VladTeapa/Platforma-Autonoma-KL25Z/README.md

# Platforma-Autonoma-FRDM-KL25Z
Acest cod este realizat pentru o platforma autonoma realizata cu kitul de la NXP care urmareste o linie si ocoleste obstacolele.
Platforma folosita este FRDM-KL25Z.
Driver-ul de motoare este tot cel de la NXP rev. 0.
Senzorii de distanta sunt model HC-SR04+.
IDE-ul folosit este Keil.
