VladTeapa/Platforma-Autonoma-KL25Z/Hariga_George_C114C_Platforma_autonoma.docx

ROMÂNIA

MINISTERUL APĂRĂRII NAȚIONALE

ACADEMIA TEHNICĂ MILITARĂ ,,FERDINAND I”

FACULTATEA DE SISTEME INFORMATICE ȘI SECURITATE CIBERNETICĂ

Specializare: Calculatoare și Sisteme Informatice pentru Apărare și Securitate Națională

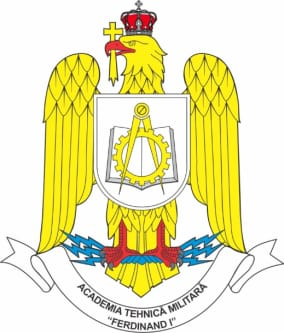
[picture p1: figure]

PLATFORMĂ AUTONOMĂ MOBILĂ CARE SE DEPLASEAZĂ URMÂND UN TRASEU MARCAT, IDENTIFICAT PRIN ANALIZĂ DE IMAGINE, CU OPTIMIZAREA TIMPULUI DE PARCURGERE A UNEI PORȚIUNI DELIMITATE DE TRASEU

CONDUCĂTOR ȘTIINȚIFIC:

Conf. univ. dr. ing Laurențiu MĂRGĂRIT

ABSOLVENT:

Student plt. maj. George-Codrin HARIGA

Conţine ___________ file

Inventariat sub nr. _____

Poziţia din indicator: ___

Termen de păstrare: ___

BUCUREȘTI

2021

# Abstract

This project aims to create an autonomous platform that travels on a delimited route with the possibility of avoiding obstacles that may arise along the way. The components used in the NXP Cup competition (formerly known as the Freescale Cup) are largely used.

The first chapter has an introductory role, where the project is described and its purpose, the choice of the project is described, a history of similar projects, which currently exists on the market and the working environment in which the source code for the project is made.

The second chapter has the role of presenting each component in general, their operating parameters, what role and what functionalities they have.

The third chapter presents the hardware configuration, how the development platform and auxiliary platform modules are physically linked. The amplifier platform and that of the distance sensors, their electrical diagrams and their functionality are also presented.

The fourth chapter has the role of presenting the software implementation. The implemented drivers and algorithms developed for line detection and avoiding obstacles are presented.

The fifth chapter presents the way in which the debugging was done, what tests were done to calibrate the system and to verify the functionalities. This chapter also contains UML diagrams to facilitate understanding of the algorithms and how to interact with the platform.

The sixth chapter presents the conclusions drawn and the problems encountered along with possible solutions.

# Rezumat

Acest proiect de licență își propune realizarea unei platforme autonome care să se deplaseze pe un traseu delimitat cu posibilitatea de a ocoli obstacolele care pot apărea pe parcurs. Se folosesc, în mare, componentele folosite la competiția NXP Cup (cunoscută in trecut ca și Freescale Cup).

Primul capitol are rol introductiv, unde, este descris proiectul și scopul acestuia, este descrisă alegerea proiectului, un istoric despre proiecte asemănătoare, ce există la ora actuală pe piață și mediul de lucru în care este realizat codul sursă pentru proiect.

Al doilea capitol are rolul de a prezenta fiecare componentă la modul general, parametrii lor de funcționare, ce rol au și ce funcționalități au.

Al treilea capitol prezintă configurația hardware, cum sunt legate fizic modulele de platforma de dezvoltare și de platformele auxiliare. Sunt de asemenea prezentate platforma amplificatoare și cea a senzorilor de distanță, schemele lor electrice și ce funcționalitate au.

Al patrulea capitol are rolul de a prezenta implementarea software. Sunt prezentate driverele implementate și algoritmii dezvoltați pentru detecția liniei, menținerea traseului și ocolirea obstacolelor.

Capitolul al cincilea prezintă modul în care s-a făcut debug, ce teste s-au realizat pentru a calibra sistemul și pentru a verifica funcționalitățile. Acest capitol conține și diagrame UML pentru a facilita înțelegerea algoritmilor și a modului de interacțiune cu platforma.

Capitolul al șaselea prezintă concluziile trase și problemele întâmpinate împreună cu posibilele soluții.

Nr. | Abreviere | Semnificație
1 | AD | Analog to digital
2 | ADC | Analog to digital converter
3 | AO | Analog output
4 | CLK | Clock
5 | DIY | Do it yourself
6 | FRDM | Freedom
7 | GND | Ground
8 | GPIO | Genral purpose input output
9 | IDE | Integrated development environment
10 | LSB | Least semnificant bit
11 | MSB | Most semnificant bit
12 | MUX | Multiplexer
13 | OSR | Over sampling ratio
14 | PCB | Printed circuit board
15 | PID | Proporțional, integrativ, derivativ
16 | PIT | Periodic interrupt timer
17 | PTXn | Port X pin n
18 | PWM | Pulse-width modulation
19 | RX | Reciever
20 | SAR | Successive approximation register
21 | SI | Serial input
22 | SIM | System integration module
23 | SRAM | Static random-access memory
24 | TPM | Timer/PWM module
25 | TRIG | Trigger
26 | TX | Transmitter
27 | UART | Universal asynchronous receiver-transmitter
28 | UML | Unified modeling language
29 | VCC | Voltage common colector
30 | VDD | Voltage drain drain
31 | VIN | Voltage input
32 | VOUT | Voltage output
33 | VREF | Voltage reference

# 1. Introducere

## 1.1. Descrierea proiectului

Platforma autonomă se deplasează pe traseul marcat cu ajutorul a două motoare de curent continuu de 7.2V, iar direcția este controlată de un servomotor MG995. Pentru a putea detecta linia traseului este folosit un modul LineScanCamera de la Texas Advanced Optical Solutions (128x1 pixeli), iar pentru a evita obstacolele se folosesc trei senzori pe bază de unde ultrasonice, model HC-SR04+, pentru a luat date dintr-un unghi mai larg. Plăcuța de dezvoltare este un FRDM-KL25Z cu un microprocesor ARM Cortex-M0+ cu 128KB de memorie flash și 16KB de SRAM, produsă de NXP. Toate acestea vor fi conectate la o baterie de 8V și 2500mAh și puse pe mașinuța din kitul de la NXP. Proiectul va putea fi folosit ca o baza a unor software-uri, mai complexe, ce vor fi folosite în scenarii reale. Să luam ca exemplu un autoturism și pilotul automat al acestuia. Autovehiculul ar putea folosi funcționalitatea proiectului de parcurgere a traseului, menținând banda, având ca delimitator marcajele de pe drum. Un alt lucru important pe care l-ar putea face pilotul automat, este sa evite obstacolele, cum ar fi: pietoni, gropi, alte mașini sau orice obiecte care ar putea avaria mașina sau care ar putea pune în pericol viața cuiva. Avantajul ocolirii automate este că are timp de reacție mai bun și poate vira mașina mai optim și mai bine decât un om ar putea, dacă este implementat totul corect, și astfel s-ar putea evita un număr considerabil de accidente. O altă aplicabilitate ar putea fi trimiterea unei astfel de platforme într-o zonă de risc pentru oameni cum ar fi o zonă cu radiații unde un om ar putea fi afectat.

## 1.2. Alegerea proiectului

Proiectul își propune să eficientizeze timpii de răspuns ai platformei autonome și mărirea preciziei în evitarea obstacolelor prin intermediul unor date de natură optică și acustică. Un alt obiectiv important al acestui proiect este reprezentat de reducerea cât mai mult a consumului de energie electrică fără a afecta capabilitățile sistemului automat.

## 1.3. Istoric

Creearea unei platforme autonome cu aceste funcționalități nu este ceva nou. Spre exemplu, NXP Cup organizeaza anual un concurs pe această temă, cu proba de traseu (unde contează timpul de parcurgere și energia consumată), proba de obstacole (ocolirea obstacolelor), proba traseului în forma de opt și o alta probă unde mașina trebuie sa fie capabilă să detecteze semnele de circulație. Pentru a construi o astfel de platformă, participanții foloseau în general o placuță de dezvoltare FRDM-KL25Z, un shield FRDM-TFC, două motoare de curent continuu, un servomotor, un LineScanCamera, o baterie și în funcție de proba la care participau alți senzori. Ca mediu de dezvoltare pentru acest concurs se folosesc MCUXpress, Keil µVision, CodeWarrior, Mbed Studio, Matlab/Simulink. Alte proiecte asemănatoare au fost realizate și cu alte placuțe de dezvoltare precum Arduino Uno sau Raspberry Pi, însă microcontrollerul de la Arduino (Atmega328p) nu este la fel de rapid, iar Raspberry Pi este cu mult mai puternică decât este necesar și are prin urmare un consum mai mare de energie. Putem da un exemplu, din viața cotidiană a aplicării funcționaltităților acestui proiect și anume, tehnologia Lane assist. Aceasta folosește datele de la o cameră atașată la oglinda retrovizoare pentru a menține autovehiculul pe banda sa. Un alt exemplu este funcția Summon de la autoturismele Tesla prin care, mașina poate veni singura către proprietar ocolind obstacolele (precum alte mașini).

## 1.4. Mediu de lucru

Mediul de lucru folosit pentru acest proiect este Keil µVision 5. Structura unui proiect în acest IDE este următoarea:

- Directorul parinte care denumirea de forma Project: <nume proiect>;
  - Target 1, numele implicit al directorului creat de IDE, acesta va fi modificat în Licenta pentru proiectul acesta;
    - Source Group 1, acesta initial este gol și aici se vor crea toate sursele necesare, denumirea va fi modificată în src pentru acest proiect;
    - inc, este un grup creat ulterior care conține toate fișierele de tip header folosite pentru dezvoltarea proiectului.
  - Următoarele fișiere vor conține surse generate de mediul de dezvoltare în funcție de ce module sunt introduse de către utilizator.

# 2. Configurație generală

## 2.1. Platforma FRDM-KL25Z

Această platformă conține un microprocesor ARM Cortex-M0+ cu frecvența de 48Mhz, are 128KB memorie flash, 16KB memorie SRAM si 80 de pini. Frecvența magistralei și frecvența flash-ului sunt jumătate din cea a procesorului și anume 24Mhz (De reținut că aceste frecvențe sunt maxime și placuța poate fi folosită la frecvențe mai mici). De asemenea mai conține doi senzori, un accelerometru MMA8451Q, un touch ,,slider” capacitativ și un LED RGB. Pentru a se putea depana pe această placuță se va folosi interfața OpenSDA (Portul se poate vedea în figura 1). Avantajul acestei platfome este că funționează la tensiuni de alimentare mici și are consum de energie electrică redus. Placuța este Mbed enabled și suportă Zephyr OS.

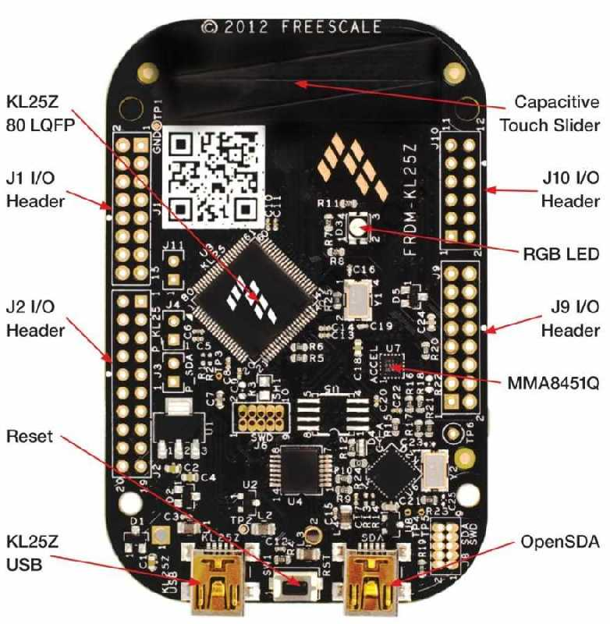
[picture p2: figure]
Buy FRDM-KL25Z Development Board with cheap price

Fig. 2.1 FRDM-KL25Z

## 2.2. Servomotor

Servomotorul este un MG995. Acesta are rolul de a schimba direcția de mers a platformei mobile. Servomotorul va fi conectat la GND, la 5V și va primi, de la placuța de dezvoltare, un semnal PWM (Pulse Width Modulation). Semnalul va avea frecvența de 50Hz (sau perioada 20ms), iar factorul de umplere va fi de la 2.5% (poziția minimă) la 12.5% (poziția maximă), toate celelalte unghiuri aflându-se între aceste două valori. Pentru a genera semnalul PWM, se va folosi modulul TPM (Timer PWM Module) al placuței KL25Z.

## 2.3. Motoare

Motoarele au rolul de a transforma energia electrică în energie mecanică si astfel, să deplaseze platforma. Pentru a putea fi folosite, vor fi cuplate la un driver de motoare, o punte H, care va primi ca input semnalele PWM (care sunt generate tot cu ajutorul unui TPM ca la servomotoare) generate de plăcuță și vor transmite un curent electric, la motoare, cu valori între -7.2V si 7.2V (Valorile negative sunt pentru a schimba sensul de rotație). Motivul pentru care este necesar un driver de motoare este faptul că, dacă conectăm motoarele direct la placuța de dezvoltare, există o posibilitate mare să se ardă circuitele acesteia sau să nu aibă puterea necesară pentru a se deplasa.

## 2.4. Modulul LineScanCamera

Acest modul poate produce o image de 128x1 pixeli și poate fi vazută ca un semnal pe care platforma îl va folosi pentru a detecta forma traseului. Pentru aceasta, camera are la puși dispoziție cinci pini. Pinul SI (Serial Input) are rolul de a începe o scanare. Pinul CLK va primi ca input un semnal de ceas generat de placuța de dezvoltare. Prin intermediul pinului AO (analog output) se vor transmite pixelii ca valori analogice ce vor fi furnizați modulului ADC al platformei. Pinii VDD și GND sunt folosiți pentru a alimenta modulul. Dacă se crește frecvența ceasului prea mult, riscăm ca pixelii să nu aibă timp destul de expunere, iar dacă setăm frecvența prea mica, pixelii vor fi supraexpuși. De aceea trebuie sa găsim un echilibru pentru aceste valori. Modul de operare a acestui modul este reprezentat în diagrama următoare:

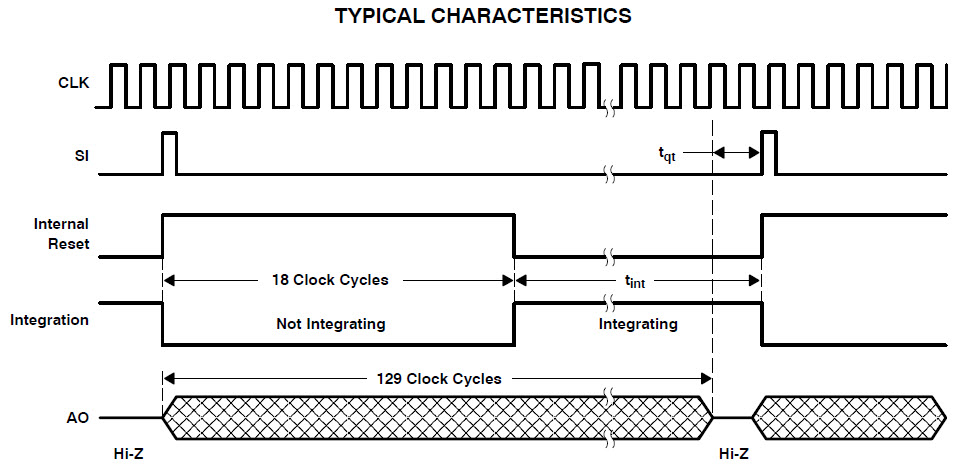
[picture p3: figure]

Fig. 2.2 Caracteristici semnale cameră

## 2.5. Senzori ultrasunet

Pentru a detecta obstacolele vom folosi trei senzori de distanță HC-SR04+. Acest tip de senzor are patru pini și anume, VCC și GND pentru alimentare, TRIG, pin de input prin care putem comunica modulului să înceapă o măsurătoare și ECHO, pin de output prin intermediul căruia vom calcula distanța propriu-zisă. Modulul are următorul principiu de funcționare:

- Se transmite un impuls cu valoarea HIGH timp de 10us pe pinul TRIG.
- Modulul trimite opt unde dreptunghiulare la o frecvență de 40KHz.
- Pinul Echo este setat pe HIGH.
- Se așteaptă întoarcerea undelor sonore, moment în care pinul Echo este setat pe LOW.

Senzorul poate măsura distanțe de la 2cm până la 450cm în funcție de tensiunea de alimentare.

Tensiunea de alimentare poate fi și de 5V și de 3.3V, dar pentru acest proiect, vom alimenta modulul la 3.3V întrucât nu avem nevoie de distanțe mai mari de 400cm. Pinii sunt prezentați în Fig. 2.3.

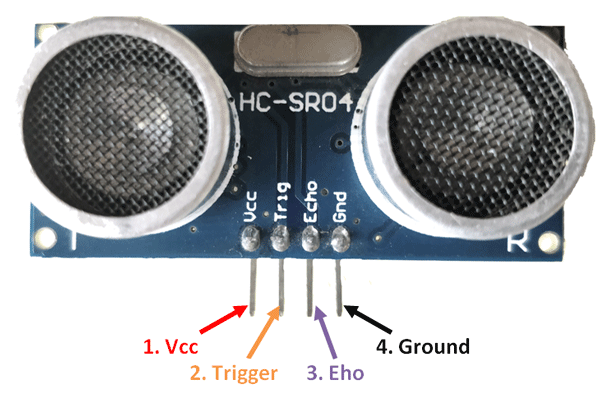
[picture p4: figure]
HC-SR04 Ultrasonic Sensor: Working, Pin Diagram, Description & Datasheet

Fig. 2.3 Senzorul HC-SR04+

## 2.6. XBee

Pentru a putea realiza o depanare de la distanță și pentru a primi date de la platformă (informații precum loguri) vom folosi două module XBee care ne asigură o comunicație wireless. Aceste module au la bază protocolului 802.15.4, comunică la o frecvență de 2.4Ghz și sunt alimentate la o tensiune de 5V. Pentru a transmite date și pentru a primi date de la aceste module se va folosi interfața UART cu un baud rate de 9600. Fig. 2.4 prezintă pinii acestor module.

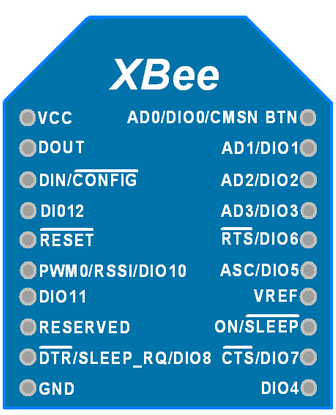
[picture p5: figure]

Fig. 2.4 Modulul XBee

Modulul atașat platformei este folosit cu ajutorul unui XBee Explorer Regulated, produs de Sparkfun (Fig. 2.5). Astfel, modulul va avea doar patru pini care vor folosiți și anume: VCC, GND, TX, RX. Primii doi sunt folosiți pentru alimentarea modulului, iar RX și TX sunt folosiți pentru comunicarea propriu-zisă prin UART. Pentru modulul care va fi conectat la distanță, vom folosi un XBee Explorer USB produs tot de Sparkfun pentru a-l putea conecta la un laptop.

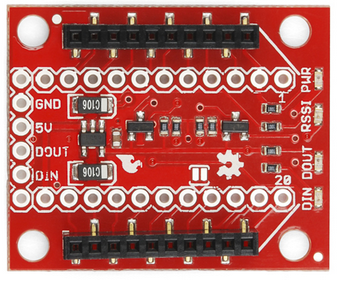
[picture p6: figure]

Fig. 2.5 XBee Explorer Regulated

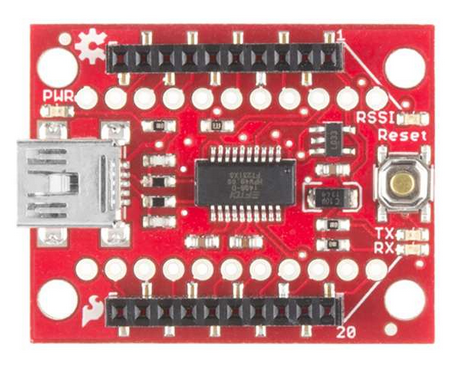
[picture p7: figure]

Fig. 2.6 XBee Explorer USB

## 2.7. Senzor magnetic cu efect Hall

Pentru a putea măsura viteza platformei s-au lipit pe interiorul roții din partea din spate dreapta șase magneți care ne vor ajuta să măsurăm turația. Vom folosi un senzor magnetic cu efect Hall model Honeywell alimentat la 3.3V. Acesta conține trei pini, VCC, GND și ieșirea. Ieșirea este de tip active low, iar acest lucru înseamnă că senzorul ne va furniza o tensiune de 0V în momentul în care magnetul este aliniat cu senzorul și invers în momentul în care magnetul nu mai este aliniat. În Fig. 2.7 se pot vedea pinii senzorului.

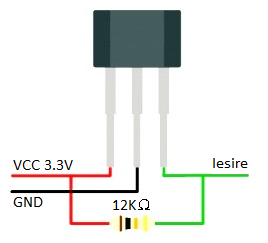
[picture p8: figure]

Fig. 2.7 Senzor magnetic cu efect Hall

## 2.8. Platforme ajutătoare

Pentru a putea comanda motoarele și servomotoarele avem nevoie de o tensiune de 5V, însă semnalele provenite de la FRDM-KL25Z sunt de 3.3V. Una din platformele ajutătoare amplifică semnalele provenite de la placuța de dezvoltare la 5V și acționează ca o interfață între placută și driverul de motoare.

O altă problemă este poziționarea senzorilor de distanță, iar ca o soluție la această problemă s-a construit o mică platformă care să acționeze ca o interfață între placuța de dezvoltare și senzori și pe care aceștia să fie poziționați.

# 3. Configurația hardware

În acest capitol vom vorbi despre cum sunt legate fizic modulele între ele, și vor fi explicate circuitele logice auxiliare folosite. Pentru realizarea schemelor electrice ale PCB-urilor s-a folosit o aplicație denumită DIY Layout Creator.

## 3.1. Platforma amplificatoare

Această placuță PCB are rolul de a amplifica semnalele provenite de la placuța de dezvoltare. Pentru amplificarea semnalului, s-a folosit un amplificator model M74HCT244B1 (Fig. 3.1) alimentat la 5V.

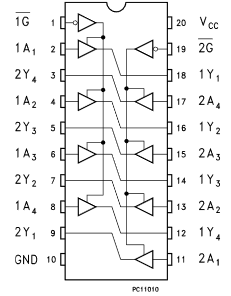
[picture p9: figure]

Fig. 3.1 M74HCT244B1

Pinii acestui circuit logic sunt codificați astfel:

- Pinii care sunt de forma nAn sunt intrările.
- Pinii care sunt de forma nYn sunt ieșirile.
- Pinii care sunt de forma nG sunt pinii de enable.
- Pinii VCC și GND sunt pentru alimentare.

Întrucât platforma de dezvoltare trebuie să poată schimba sensul de rotație al motoarelor, iar platforma pentru controlul motoarelor nu are funcționalitatea de a inversa polaritatea semnalul primit, a fost necesară introducerea unui multiplexor model 74157N (Fig. 3.2), alimentat la 5V.

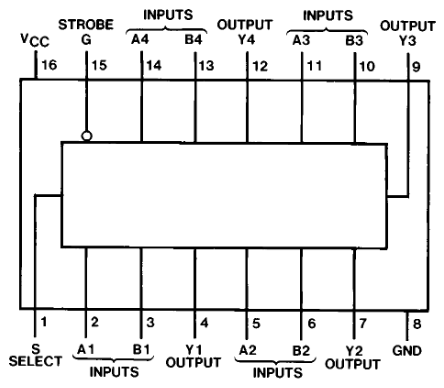
[picture p10: figure]

Fig. 3.2 74157N

Pinii acestui circuit logic sunt codificați astfel:

- Perechile de pini An, Bn sunt semnalele ce vor fi multiplexate.
- Pinii care sunt de forma Yn sunt ieșirile pentru semnalele multiplexate.
- Pinul G este pinul de enable.
- Pinul S este pinul de selecție al semnalului.
- Pinii VCC și GND sunt pentru alimentare.

Astfel, având acest multiplexor, putem inversa polaritatea semnalului PWM furnizat de amplificator și implicit, putem schimba sensul de rotație al motoarelor.

Pentru a asigura o legătură mai ușoară între senzorul de turație, cameră, XBee și plăcuța de dezvoltare, au fost lipiți pini adiționali pe această placută PCB conform Fig. 3.3 care este prezentată mai jos. Fig. 3.4 este plăcuța amplificatoare fotografiată în realitate.

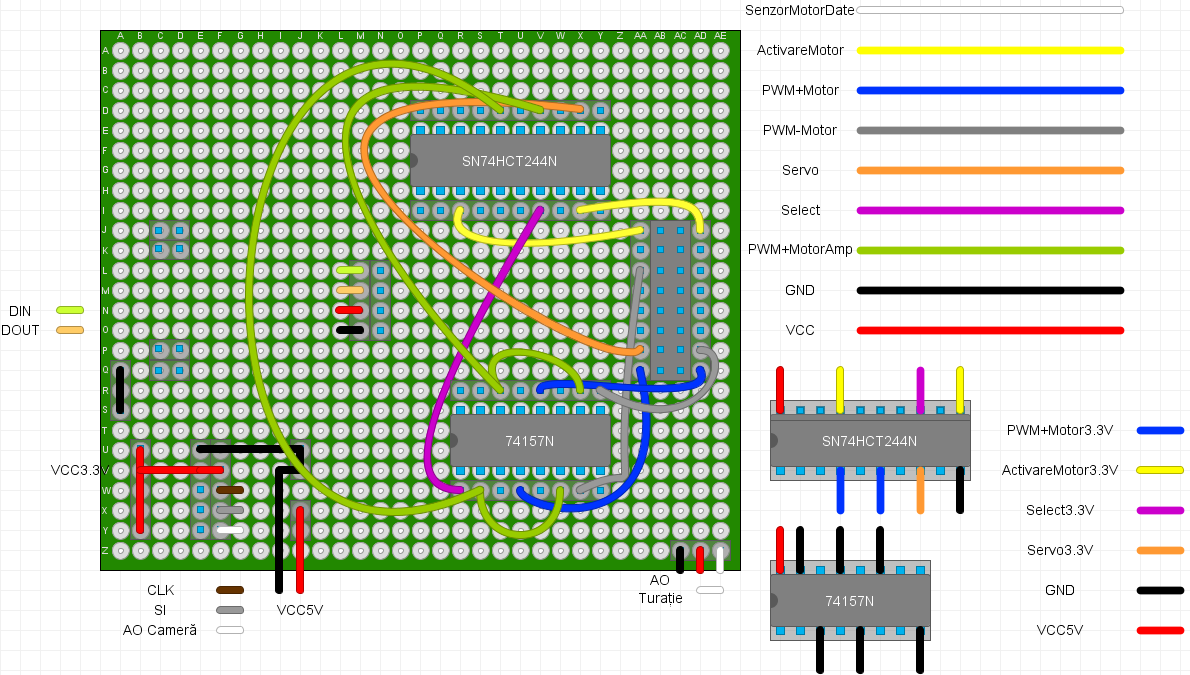
[picture p11: figure]

Fig. 3.3 Schemă platforma amplificatoare

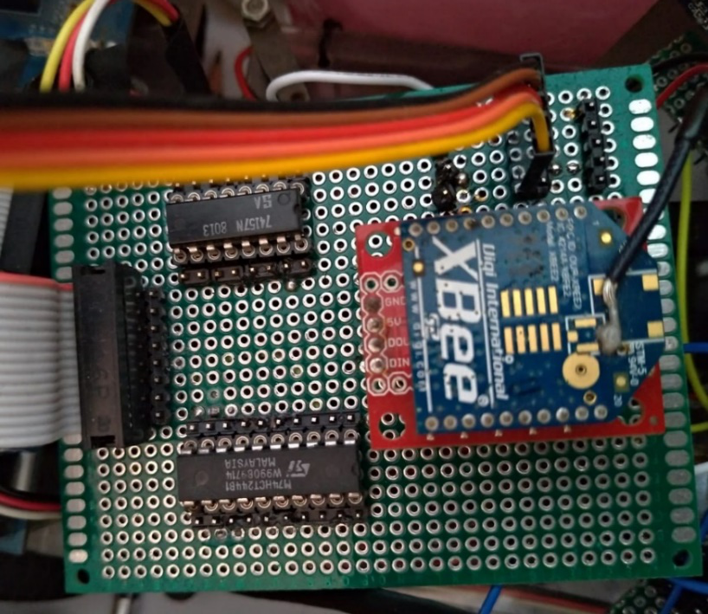
[picture p12: figure]

Fig. 3.4 Poză platforma amplificatoare

Pinii pentru cameră, pentru XBee și pentru senzorul de turație nu trec prin circuite logice intermediare. Pinii de la coordonatele JC, JD, KC, KD, PC, PD, QC, QD (Fig. 3.3) nu sunt legați la nimic și au doar rolul de suport mecanic pentru modulul XBee. Pinii sunt dublați în unele locuri pentru a ușura realizarea conexiunilor fizice.

În următorul tabel avem prezentate toate conexiunile dintre placuța de dezvoltare, placuța amplificatoare și cupla pentru platforma care controlează motoarele, unde este cazul. Pinii de forma An sunt pinii circuitului amplificator, pinii Mn sunt pinii multiplexorului, săgețile reprezintă ieșirile din circuitele logice, virgula reprezintă conexiuni multiple, caracterul ,,/” semnifică faptul că ieșirea depinde de semnalul de select al multiplexorului, iar liniuțele sunt conexiunile prin fire.

Funcționalitate pin | Legătura fizică
Activare motor stânga | PTD3-A17->A3
Activare motor dreapta | PTD2-A11->A9
PWM motor stânga | PTA5-A6->A14-M10,M14->M12/M9
PWM motor dreapta | PTD1-A4->A16-M2,M6->M4/M7
PWM servomotor | PTA12-A8->A12
Selecție direcție sens motoare | PTD5-A13->A7
SI cameră | PTC6
CLK cameră | PTC7
AO cameră | PTB0
AO senzor turație | PTB3
DIN XBee | PTA1
DOUT XBee | PTA2

Tabel 3.1 Configurație platformă amplicatoare

Outputul camerei este conectat la modulul ADC0 (singurul modul ADC existent pe FRDM-KL25Z) al platformei de dezvoltare în modul ,,single-ended” pe canalul 8 (ADC0_SE8). Acest mod de conectare semnifică faptul că nu sunt nevoie două conexiuni pentru a măsura valoarea de pe pinul AO al camerei, modulul ADC folosind ca referință masa comună tuturor circuitelor și ca semnal de intrare o singura conexiune.

Dacă modulul LineScanCamera ar fi avut altă masă conectată decât cea a platformei și implicit a modulului ADC0, ar fi fost necesară o altă configurație al convertorului AD și anume, cea diferențială, fiind necesare două conexiuni fizice în loc de una pentru a putea măsura outputul. Un avantaj față de modul ,,single-ended” este eliminarea zgomotului prin torsadarea celor două conexiuni, însă, din observații, modul în care este folosit canalul modulului ADC0, nu introduce zgomot suficient de puternic încât să afecteze funcționalitatea camerei.

## 3.2. Platforma senzorilor de distanță

Această plăcuță PCB are rolul de a fixa fizic și de a conecta senzorii de distanță la platforma mobilă. Au fost necesare trei PCB-uri, deoarece senzorii trebuie să măsoare distanțele pe trei direcții diferite. Acestea sunt fixate cu ajutorul unor tije metalice și lipite între ele pentru a forma o singură platformă. Conexiunile existente sunt vizibile în Fig. 3.5, iar în Fig. 3.6 este o fotografie cu platforma în realitate.

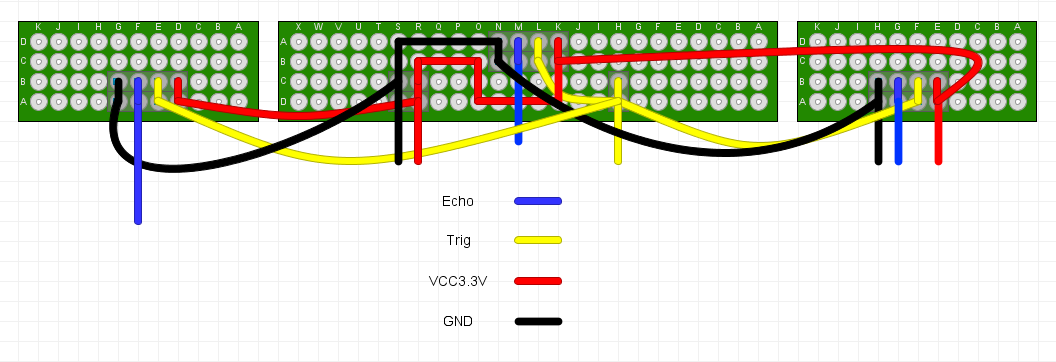
[picture p13: figure]

Fig. 3.5 Schemă platforma senzorilor de distanță

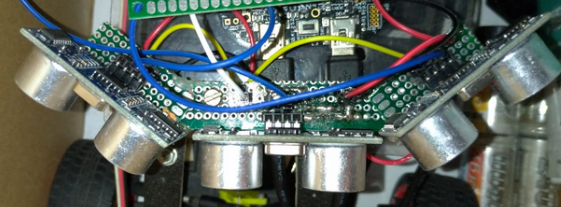
[picture p14: figure]

Fig. 3.6 Poză platforma senzorilor de distanță

Întrucât cei trei senzori vor începe măsurătorile în același timp, pinul Trig al fiecărui senzor este conectat la pinul de pe PCB-ul din mijloc de la poziția DH (Fig. 3.5). Acest lucru ușurează și implementarea software și ușurează și conectarea senzorilor la FRDM-KL25Z. Pinii de alimentare, VCC și GND sunt conectați la platforma amplificatoare la 3.3V și sunt comuni la cei trei senzori.

În următorul tabel sunt prezentate conexiunile dintre platforma de dezvoltare și platforma senzorilor sunt prezentate. Pinii de forma PTXn sunt pinii de pe plăcuța de dezvoltare, abrevierile de forma nYX reprezintă PCB-ul și coordonatele din Fig. 3.5, iar liniuțele sunt conexiunile prin fire.

Funcționalitate pin | Legătura fizică
Trig (toți senzorii) | PTD4-2CH
Echo senzor dreapta | PTD7-3AG
Echo senzor stânga | PTD6-2BM
Echo senzor mijloc | PTA17-1AF

Tabel 3.2 Configurație platforma senzorilor de distanță

## 3.3. Conectarea tuturor platformelor

Platforma de amplificare și platforma senzorilor de distanță sunt conectate la plăcuța de dezvoltare cu ajutorul unor jumperi, iar conexiunea dintre driverul de motoare și restul circuitelor de amplificare și multiplexare s-a realizat cu ajutorul unui cablu de tip ATA, cu 16 pini dispuși pe două rânduri, conectat la interfața JP2 aflată pe driverul de motoare.

# 4. Implementarea software-ului

În acest capitol vom descrie software-ul dezvoltat pentru realizarea cerințelor temei alese.

Proiectul constă într-o aplicație de tip ,,bare metal” dezvoltată cu ajutorul IDE-ului Keil µVision 5. ,,Bare metal” înseamnă că aplicația nu se folosește de un sistem de operare instalat deja pe platforma de dezvoltare și prin urmare, sistemul va fi mai rapid. O alternativă ar fi fost folosirea IDE-ului Mbed care ne pune la dispoziție sistemul de operare Mbed OS. Din considerente de viteză de procesare a sistemului s-a ales în final varianta ,,bare metal”. Acest lucru înseamnă, în schimb, că toate drivele pentru modulele folosite trebuie scrise de dezvoltator.

Proiectul este împărțit pe mai multe surse pentru a avea o lizibilitate mai mare în citirea codului.

## 4.1. Configurație generală

IDE-ul folosit generează mai multe fișiere pentru a configura sistemul per ansamblu. Inițial, platforma este configurată să aibă frecvența procesorului de 20.97125MHz și frecvența magistralei tot 20.97125MHz. Pentru a mări viteza de procesare, s-a ales o altă configurație care setează procesorul să funcționeze la o frecvență de 48MHz și magistrala la 24MHz. Modulele TPM, UART, PIT folosesc toate ceasul MCGFLLCLK care are frecvența de 48MHz pentru această configurație.

## 4.2. Driver GPIO

Modulul GPIO (General purpose input output) are rolul de a transmite sau de a primi date digitale sub forma unor biți (0 sau 1). Aproape toți pinii pot fi configurați să fie de acest tip. Exemple clasice de folosire a unor pini configurați astfel sunt: aprinderea/stingerea unui LED, activarea/dezactivarea unui modul, conectarea unor display-uri, etc.

Pentru a putea configura pinii să funcționeze ca GPIO aceștia trebuie să fie multiplexați corespunzător, configurând în registrul PORTx_PCRn valoarea 1 în câmpul MUX, iar ceasul trebuie activat pentru portul corespunzător în registrul SIM_SCGC5. Direcția pinului (adică dacă este de output sau input) se poate alege prin configurarea registrului GPIOx_PDDR, citirea de la un pin se realizează cu ajutorul registrului GPIOx_PDIR, iar setarea valorii de output se realizează cu ajutorul următoarelor registre: GPIOx_PCOR (setează valoarea 0), GPIOx_PSOR (setează valoarea 1), GPIOx_PTOR (toggle).

La acest proiect s-au folosit cinci pini GPIO și anume: activare motor dreapta, activare motor stânga, direcție motoare, SI cameră și CLK cameră.

Pentru activarea motorului drept s-a folosit pinul PTD2. Acesta a fost configurat ca GPIO prin setarea valorii 1 în registrul PORTD_PCR2 în câmpul MUX. Pentru ca pinul să fie de tip active high, au fost necesare încă două configurări în registrul PORTD_PCR2 și anume, câmpul PE (valoarea 1) și câmpul PS (valoarea 0). Întrucât nu avem nevoie de întreruperi pentru această configurație, câmpul IRQC este setat pe valoarea 0. În final, pinul este configurat să fie output cu ajutorul registrului GPIOD_PDDR și este setat la valoarea de logic high cu ajutorul registrului GPIOD_PSOR. Pentru activarea motorului din stânga, se configurează similar pinul PTD3. Acești pini vor rămâne mereu pe valoarea de logic high întrucât nu avem nevoie să dezactivăm motoarele pentru acest proiect. Pinii pentru cameră și direcția motoarelor sunt și ei configurați similar.

Pentru a se alege sensul de mers înainte, pinul PTD5 trebuie să aibă valoarea logic low și invers pentru a schimba sensul de rotație.

## 4.3. Driver UART

UART (Universal asyncronous reciever-transmiter) este un modul folosit la comunicarea serială dintre platforma de dezvoltare și un alt dispozitiv. Semnalul transmis este compus din doi biți, unul de start și unul de sfârșit și opt biți de date. Aceștia sunt transmiși la viteze prestabilite denumite baud rates care semnifică câți biți sunt transmiși pe secundă. Un exemplu de astfel de semnal putem observa în Fig. 4.1.

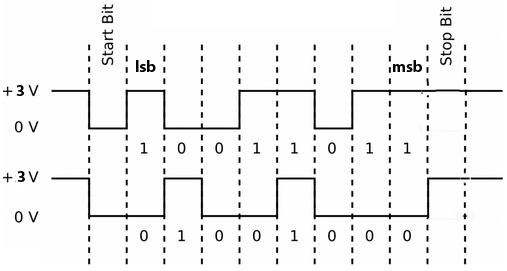
[picture p15: figure]

Fig. 4.1 Semnal UART

În cazul nostru vom folosi modulul UART0 pentru a transmite date de la plăcuța de dezvoltare la modulul XBee. Pentru aceasta vom folosi pinii PTA1 și PTA2. Baud rate-ul folosit este de 9600 și se calculează în modul următor. Se alege o valoare de OSR (over sampling ratio) între 4 și 32 (valoarea implicită este 16), în cazul nostru 15, se adună cu unu și se înmulțește cu baud rate-ul dorit. Apoi se împarte frecvența ceasului folosit (în cazul acesta MCGFLLCLK) la valoarea calculată și rezultatul îl salvăm într-o variabila denumită sbr. Din această variabilă se scriu cei opt cei mai puțini semnificativi biți în registrul UART0_BDL, iar biții de pe pozițiile 8-12 sunt memorați pe pozițiile 0-4 în registrul UART0_BDH. Valoarea de OSR este memorată registrul UART0_C4 în câmpul OSR. În continuare vom configura regiștrii UART0_C1, UART0_C3, UART0_MA1, UART0_MA2 și UART0_C2 astfel:

- UART0_C1 va avea toți biții setați pe 0;
  - Acest lucru ne asigură că mesajul are 8 biți și nu 9;
  - Generarea de bit de paritate este dezactivată;
  - Sunt selectați pini separați pentru RX și TX.
- UART_C3 va avea biții setați pe 0;
  - Întrucât nu avem nevoie de întreruperi pentru UART, vor fi dezactivate;
- UART0_MA1 și UART0_MA2 vor avea toți biții setați pe 0;
  - Datele vor fi direct transmise către registrul UART0_D.
- UART0_C2 va avea câmpurile TE și RE setate pe valoarea 1, restul sunt lăsate la valoarea implicită.
  - TE și RE sunt biții de activare a transmițătorului respectiv al receptorului.

Pentru a transmite date se va scrie în registrul UART0_D, iar pentru a citi date se va folosi același registru. Schemele logice ale transmițătorului și al receptorului sunt prezentate în următoarele două figuri.

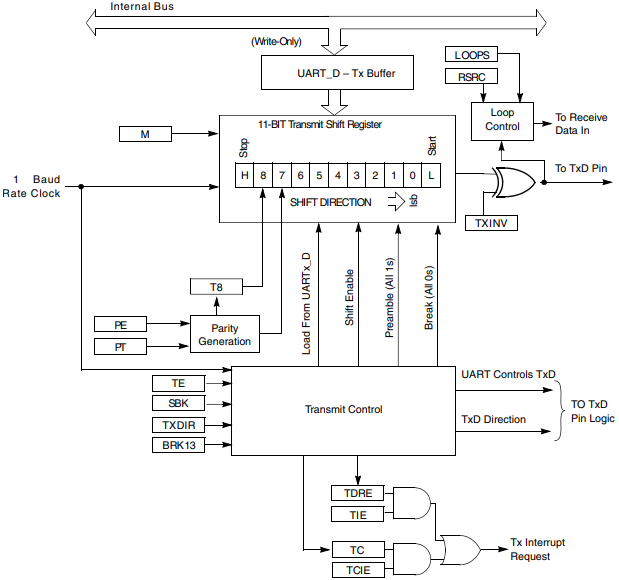
[picture p16: figure]

Fig. 4.2 Schema transmițătorului UART

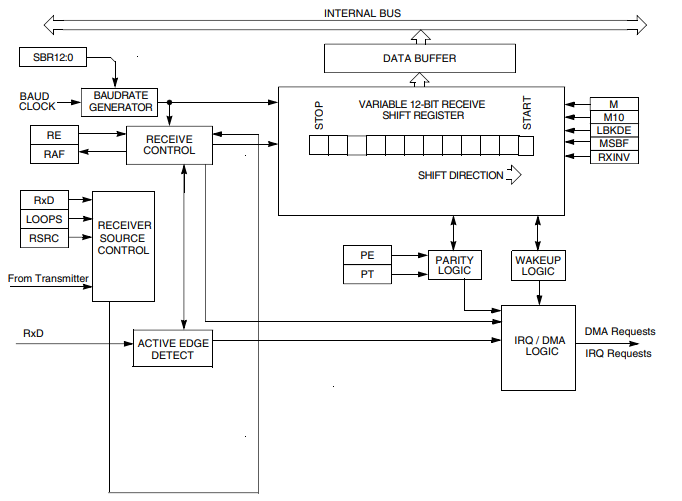
[picture p17: figure]

Fig. 4.3 Schema receptorului UART

Platforma autonomă ar putea funcționa și fără acest modul, întrucât acesta are doar rolul de debug. Testele realizate cu acest modul vor fi prezentate într-un capitol ulterior.

## 4.4. Driver TPM

TPM este un numărător pe 16 biți care are următoarele funcționalități: generare de semnal PWM, input capture și output compare. Această placă de dezvoltare conține trei module TPM și anume: TPM0 care are șase canale disponibile, TPM1 are două canale disponibile și TPM2 care are tot două canale disponibile. Următoarea figură prezintă schema bloc a unui astfel de modul.

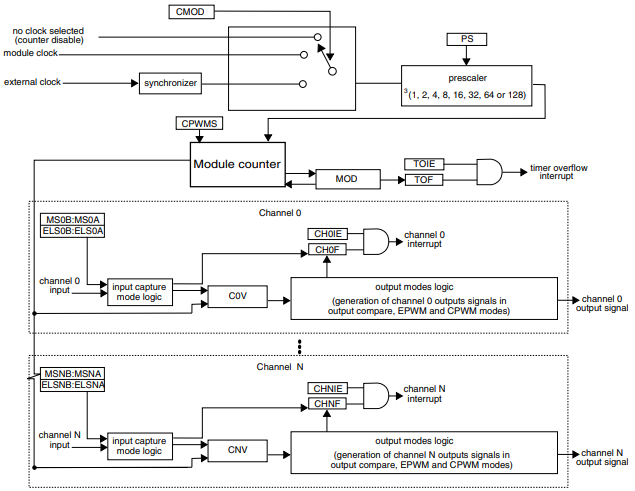
[picture p18: figure]

Fig. 4.4 Schema modulului TPM

Pentru numărare acest modul prezintă mai mulți parametri configurabili cum ar fi divizorul de ceas care poate lua valorile 1, 2, 4, 8, 16, 32, 64, 128, selectarea ceasului folosit, modul de numărare up counting sau up-down counting, valoarea până la care se numără și alții. Pentru acest proiect s-au folosit doar modurile input capture și generarea de pwm pentru controlul motoarelor, controlul servomotorului, măsurarea turației și generarea semnalulul TRIG pentru senzorii de distanță.

Modulul TPM0 este folosit pentru generarea de semnale PWM pentru motoare și pentru senzorii de distanță, TPM1 este folosit pentru sevomotor, iar TPM2 este folosit pentru senzorul de turație. Această alegere de a împărți modulele s-a datorat necesității de timpi diferiți pentru generarea flag-ului TOF și a numărului de canale disponibile pentru fiecare modul.

În continuare sunt prezentate două figuri care prezintă modurile de numărare up counting și up-down counting.

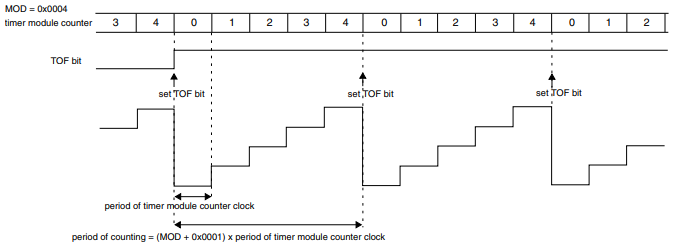
[picture p19: figure]

Fig. 4.5 TPM Up counting

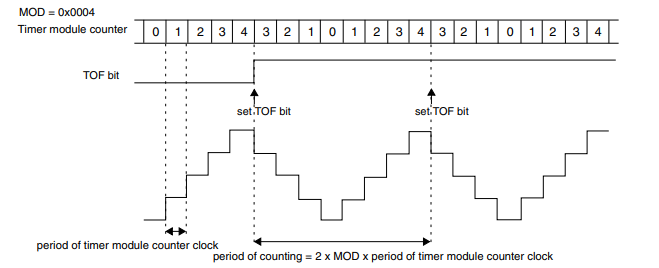
[picture p20: figure]

Fig. 4.6 TPM Up-Down counting

## 4.4.1. Generare PWM

Pentru a genera semnalele PWM folosite la motoare și servomotor s-au folosit pinii PTA12 corespunzător modulului TPM1, canalul 0 și pinii PTA5 și PTD1 corespunzatori modulului TPM0, canalului 2, respectiv 1.

Pentru aceasta, a fost necesară configurarea acestor canale să genereze semnale PWM prin setarea valorilor ELSA, ELSB, MSA, MSB în registrul TPMx_CnSC conform tabelului de mai jos pentru a alege Edge-aligned PWM, High-true pulses.

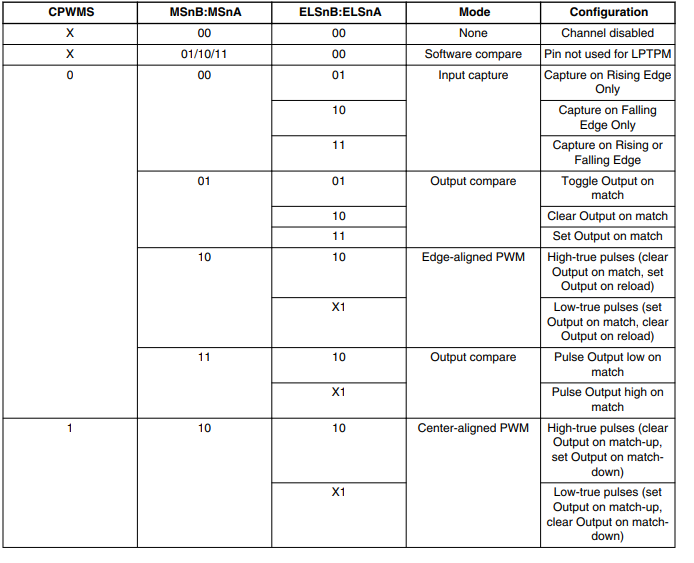
[picture p21: figure]

Tabel 4.1 TPMx_CnSC Edge, level și mod de funcționare canal

Pentru a putea seta perioada semnalului ne vom folosi de registul TPMx_MOD și vom seta valoarea 0x8CA0 și divizorul de ceas la valoarea 32 pentru TPM0 ceea ce corespunde la o perioada de aproximativ 40ms (valoare necesară pentru senzorii de distanță). Pentru a seta factorul de umplere, se va folosi registrul TPMx_CnV care va fi setat dinamic în timpul execuției, cu excepția senzorilor de distanță, unde factorul de umplere va fi constant pentru semnalul TRIG, lațimea semnalului fiind de aproximativ 10us. Pentru servomotor vom seta valoarea din TPMx_MOD la 0xEA60 și divizorul de ceas la valoarea 16 ceea ce corespunde la o perioada de aproximativ 20ms.

Fig. 4.7 TPM generare PWM

Pentru motoare s-a creat o funcție de setare a vitezei (denumită SetareViteza()) care primește ca parametru un număr de la zero la unu unde, zero înseamnă că motoarele sunt oprite (factorul de umplere 0% și implicit tensiunea de alimentare devine 0V) și unu înseamnă că motoarele funcționează la capacitate maximă. Totuși, pentru a nu accelera prea brusc motoarele s-a folosit o macrodefiniție care are valoarea 0.85 și este denumită MOTOARE_VITEZA_MAXIM_SIG având rolul de a limita factorul de umplere care este setat în final.

Pentru sevomotoare s-a creat o funcție care să seteze unghiul roților (SetareUnghi()) și primește valori între -1 și 1, unde -1 reprezintă maxim stânga și 1 maxim dreapta. Întrucât roțile nu pot fizic să realizeze o rotație foarte mare, deoarece se lovesc de cadrul platformei, s-a creat și pentru această funcție o macrodefiniție denumită SERVOMOTOR_MAXIM_SIG care are valoarea de 0.4. Această macrodefiniție, ca și la motoare, a fost creată cu scopul de a calibra sistemul, întrucât funcțiile ar fi putut limita direct semnalele la aceste valori pe care le au macrodefinițiile.

## 4.4.2. Input capture

Acest mod de funcționare are rolul de a ne ajuta să numărăm câte fronturi crescătoare, descrescătoare sau ambele apar într-un anumit interval de timp. Pentru aceasta s-a folosit pinul PTB3 corespunzător modulului TPM2, canalul 1.

Pentru a configura acest canal să funcționeze în acest mod, se setează în registrul TPMx_CnSC valorile ELSA, ELSB, MSA, MSB conform Tabelului 4.1 astfel încât să fie ales modul Input capture, Capture on Rising Edge Only. Acest mod ne va genera o întrerupere la fiecare front crescător detectat.

TPM2 are registrul TPMx_MOD setat la valoare 0xB71B și divizorul de ceas la valoarea 128 ceea ce corespunde la o perioada de aproximativ 125ms. Acest lucru înseamnă că vom putea măsura viteza de opt ori pe secundă. Pentru a realiza acest lucru, la fiecare front crescător, există o variabilă denumită nrInput care este incrementată. În momentul în care flag-ul TOF este setat și întreruperea a fost generată se calculează viteza curentă astfel:

vitezaCurenta=nrInput*NR_INPUT_COEFF ( 4.1 )

Macrodefiniția NR_INPUT_COEFF este calculată în funcție de mai mulți parametrii statici și are următoarea formulă:

NR_INPUT_COEFF=(PI*DIAMETER_OF_WHEEL)/(COEFFICIENT_MEASURE_TIME*NUMBER_OF_MAGNETS) ( 4.2 )

- PI, este constanta π și are valoarea 3.14;
- DIAMETER_OF_WHEEL, este diametrul roții exprimat în metri și are valoarea 0.05m;
- COEFFICIENT_MEASURE_TIME, este o constantă care ne va transforma din m/0.125s în m/s și are valoarea 0.125;
- NUMBER_OF_MAGNETS, este numărul de magneți de pe roată și are valoarea 6.

Se poate observa că toate valorile posibile sunt în funcție de NR_INPUT_COEFF și mai exact, multipli ai acestei constante (NR_INPUT_COEFF = 0.2093). Pentru a putea fi mai precisă măsurătoarea, ar trebui ca această constantă să aibă valoarea mai mică, iar singurul parametru care poate fi schimbat este perioada modulului TPM2. Dacă alegem o valoare mai mare a perioadei, răspunsul sistemului ar fi prea încet, dar precizia ar crește. Dacă s-ar alege o valoare mai mică a perioadei, pentru a avea un timp de răspuns mai bun, am avea în schimb următoarea problemă și anume: să presupunem că măsurăm odată la 10ms, asta ar însemna că pentru a fi siguri că măcar un magnet trece prin dreptul senzorului ar trebui ca roata să realizeze o șesime de revoluție în 10ms care este echivalentul în viteza la aproximativ 2.6m/s. Deci pentru a putea măsura viteza și să avem o valoare cât mai apropiată de realitate, platforma ar trebui să se deplaseze cu 2.6m/s și chiar și în acel caz, ar măsura doar 2.6m/s sau 5.2m/s în funcție de cum sunt plasați magneții la începutul unei măsurători. În cazul de față, cu perioada de 125ms, viteza minimă pentru a fi aproape siguri că detectăm un magnet este de aproximativ 0.20m/s ceea ce este mult mai aproape de vitezele pe care platforma le va atinge.

## 4.5. Driver PIT

Modulul PIT este folosit pentru a măsura anumite perioade de timp cu ajutorul unor serii de numărătoare. Platforma FRDM-KL25Z are un singur modul PIT cu două canale. Aceste două canale sunt folosite pentru generarea semnalului CLK a modulului LineScanCamera și pentru generarea semnalului SI. Pentru aceasta, prima oară este activat modulul PIT cu ajutorul registrului PIT_MCR prin setarea câmpului MDIS la valoarea 0. Apoi sunt activate întreruperile celor două canale cu ajutorul regiștrilor PIT_TCTRLn prin setarea câmpului TIE la valoarea 1.

Pinul folosit pentru CLK este PTC7 și pentru SI este PTC6. Pentru a putea realiza o măsurătoare cu ajutorul camerei avem nevoie să generăm cele două semnale conform figurii prezentate pe următoarea pagină.

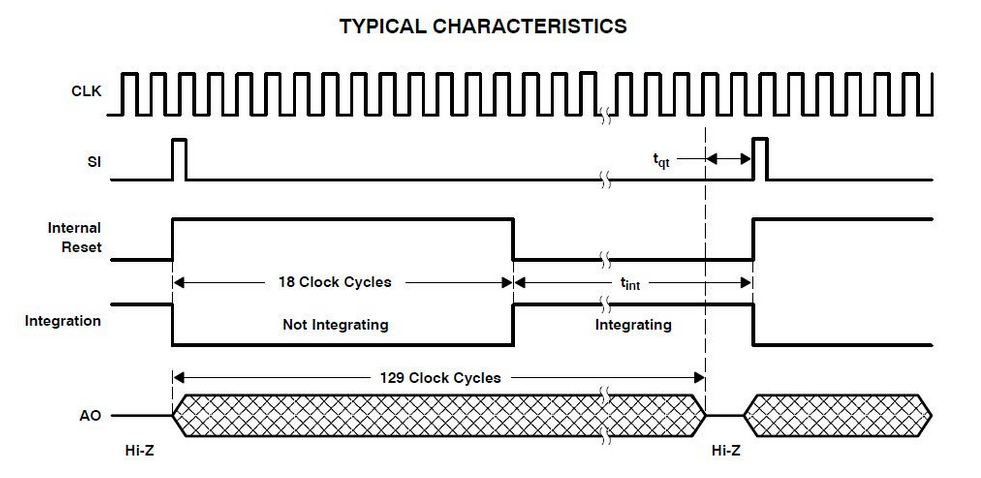
[picture p22: figure]

Fig. 4.8 Semnale LineScanCamera

Rolul canalului unu este de a genera semnalul CLK și de a începe o măsurătoare cu ajutorul modulului ADC. Acest lucru se realizează cu ajutorul întreruperii, unde valoarea pinului PTC7 este schimbată în zero dacă valoarea era unu și invers (toggle).

Rolul canalului zero este de a genera semnalul SI. Pentru aceasta, se vor considera patru stări:

- În prima stare se consideră că a fost terminată măsurătoarea anterioară și se pregătește următoarea. Se setează pinul SI pe valoarea de unu logic după care se setează canalul zero să numere timp de un sfert de perioadă a semnalului CLK;
- În a doua stare se setează CLK la valoarea de logic unu și se mai așteaptă încă un sfert de perioadă;
- În a treia stare, semnalul SI este setat la valoarea de logic zero și se așteaptă din nou un sfert de perioadă pentru starea finală;
- În ultima stare semnalul CLK este setat la valoarea de zero logic, canalul unu este activat și se începe o nouă măsurătoare.

## 4.6. Driver ADC

Modulul ADC are rolul de a converti un semnal analogic într-un semnal digital. Placuța de dezvoltare conține un singur modul ADC și anume ADC0 care are patru perechi de canale diferențiale și 24 de canale ,,single-ended”. Structura acestui modul este prezentată în figura de mai jos.

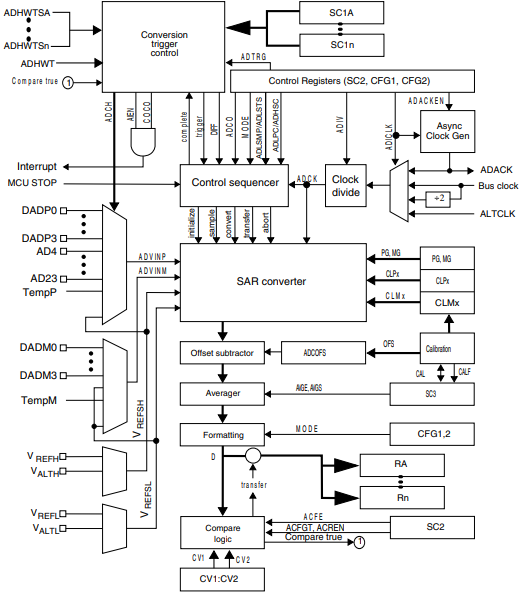
[picture p23: figure]

Fig. 4.9 Schema modulului ADC

Convertoarele AD au mai multe moduri de a realiza conversia precum SAR și Delta-Sigma. În cazul nostru modulul ADC este de tip SAR și realizează conversia prin aproximări succesive, asemănător cu o căutare binară. Avantajul unei astfel de conversii este viteza cu care se realizează operațiile, dar se pierde din rezoluție, acest modul având o rezoluție maximă de 16 biți. O reprezentare simplificată a acestui mod de a realiza conversia este prezentată în următoarea figură cu o rezoluție de 4 biți.

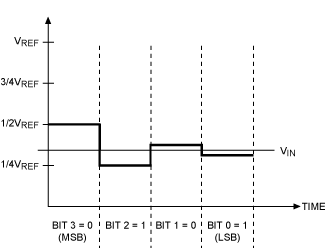
[picture p24: figure]

Fig. 4.10 SAR pe 4 biți

Acest modul este folosit pentru a prelua output-ul de la modulul LineScanCamera. Pentru aceasta s-a folosit pinul PTB0 corespunzător canalului 8 ,,single-ended”. Registrul ADC0_CFG1 a fost setat tot pe valoarea zero. Acest lucru ne asigură că modulul va realiza conversia cu o rezoluție de 8 biți, întrucât nu avem nevoie de o precizie foarte mare, sample time este setat să fie cât mai scurt, divizorul de ceas are valoarea unu, iar ceasul folosit pentru AD este Bus Clock. Registrul ADC0_CFG2 este configurat astfel încât să folosit canalele ADxxa. Modulul este dezactivat pe timpul configurării prin scrierea valorii 0x1F în registrul ADC0_SC1A. Întrucât vrem ca începerea unei conversii să se realizeze software și nu hardware se setează biții registrului ADC0_SC2 pe zero. Acest lucru ne asigură și că DMA este dezactivat și funcția de comparare este dezactivată.

Înainte de a putea configura modulul acesta trebuie calibrat. Pentru aceasta este necesară selectarea modului în care modulul face o medie a 32 de sample-uri (nu este activată și pentru folosirea modulului propriu-zisă) și este setat bitul CAL. Se verifică momentul în care bitul COCO din registrul ADC0_SC1A este setat moment în care se poate verifica dacă calibrarea a fost realizată cu succes sau nu. În final, trebuie setat gain-ul care se calculează conform manualului. Pașii care trebuie urmați sunt prezentați în continuare:

- Se inițializează o variabilă pe 16 biți.
- Se adună valorile pentru partea pozitivă a gain-ului din regiștrii ADC0_CLP0, ADC0_CLP1, ADC0_CLP2, ADC0_CLP3, ADC0_CLP4 și ADC0_CLPS și se memorează în variabila declarată la pasul anterior.
- Se împarte variabila la doi și se setează MSB-ul.
- Se salvează valoarea în registrul ADC0_PG.
- Se repetă pașii pentru partea negativă a gain-ului.

Cu ajutorul acestui modul vom măsura fiecare pixel indiviual provenit de la pinul AO al modulului LineScanCamera. Aceștia vor fi salvați într-un vector care este folosit pentru debug. Pentru a detecta linia se calculează minimul acestor pixeli. Întrucât pe margini se observă că pixelii sunt mai întunecați și mulți ajung în afara traseului, minimul se va calcula de la CAMERA_IGNORE_EDGE_VAL până la poziția 127-CAMERA_IGNORE_EDGE_VAL, unde această macrodefiniție are valoarea 12, aleasă empiric. Capetele vectorului și pozițiile corespunzătoare marginilor create cu ajutorul macrodefinițiilor vor avea, doar pentru debug valori mari pentru a se vedea delimitarea.

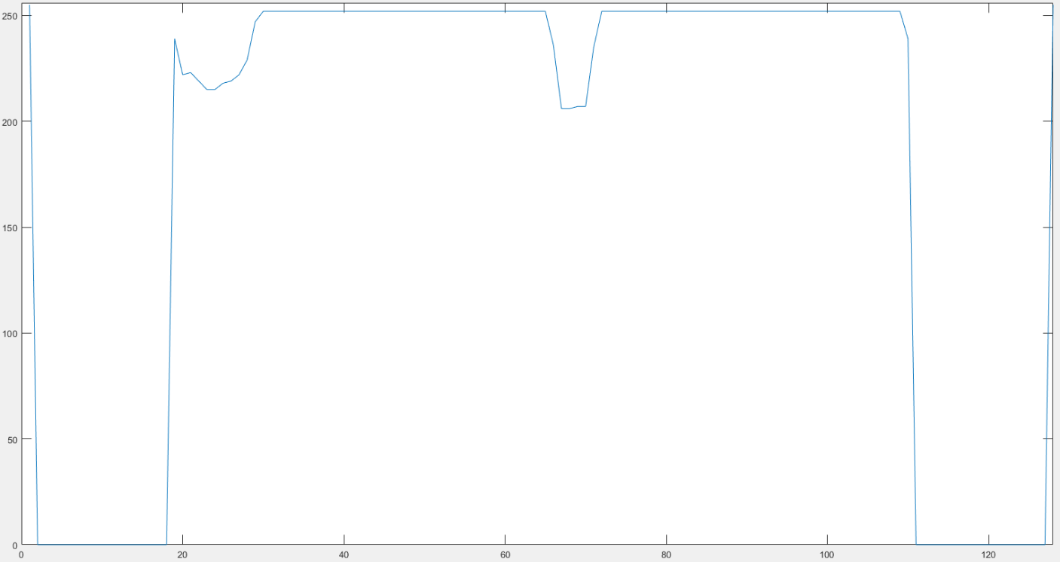
[picture p25: figure]

Fig. 4.11 Măsurătoare cameră

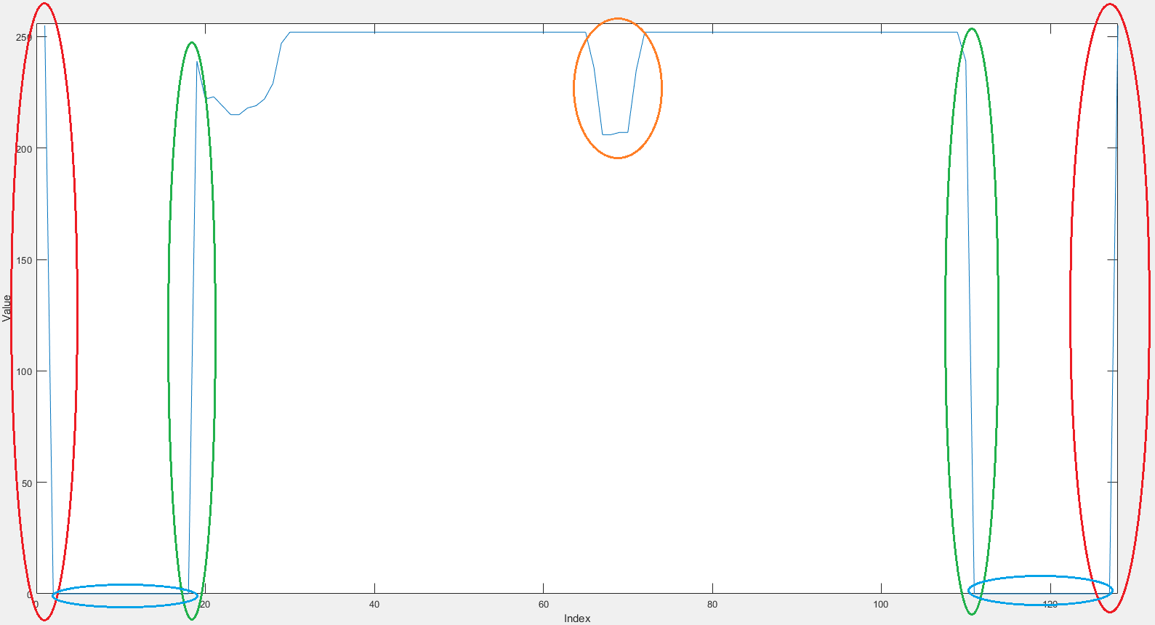
[picture p26: figure]

Fig. 4.12 Măsurătoare cameră cu indicații ale zonelor

- Roșu reprezintă marginile imaginii;
- Verde reprezintă marginile definite de CAMERA_IGNORE_EDGE_VAL;
- Portocaliu este linia neagră;
- Albastru reprezintă zonele care nu sunt reținute la măsurare.

## 4.7. Menținerea drumului

Detecția drumului se realizează cu ajutorul modulului LineScanCamera. Metoda este deja prezentată în subcapitolul Driver ADC. Pentru a decide direcția, s-a folosit funcția decideDirectiaDrumSimplu() din subsistemul Sistem Decizional. Această funcție primește ca parametru poziția liniei calculată în întreruperea modulului ADC și returnează o valoare între -1 și 1 pentru servomotor. Modul în care se calculează este astfel:

- Se inițializează o variabilă temp cu valoarea 128, adică numărul de pixeli dintr-o măsurătoare;
- Se scade de două ori SERVOMOTOR_THRESHOLD din temp (macrodefiniția definește din ce punct motoarele vor vira maxim stânga, respectiv dreapta și are valoarea 12, aleasă empiric);
- Se face raportul dintre poziția liniei relativa la valoarea macrodefiniției SERVOMOTOR_THRESHOLD și temp (Acest nou rezultat este o variabilă între 0 și 1);
- Se înmulțește cu doi rezultatul anterior și se scade unu.

Matematic calculul are următoarea formulă:

unghi= 2* (linie-SERVOMOTOR_THRESHOLD)/(128-2*SERVOMOTOR_THRESHOLD) + 1 ( 4.3 )

Pentru a se decide viteza, se folosește funcția decideVitezaDrumSimplu() din subsistemul Sistem Decizional. Această funcție primește ca parametru poziția liniei și returnează viteza dorită. Viteza este decisă în modul următor:

- Dacă linia se află în vecinătatea mijlocului (vecinătate delimitată de o macrodefiniție denumită LINE_MAX_ERROR_FOR_SPEED care are valoarea 5, aleasă empiric) atunci viteza este setată la viteza maximă ca pentru un drum drept;
- Dacă linia nu se află în vecinătatea mijlocului, viteza este setată la una mai mică pentru curbe.

Cele două viteze (pentru drum drept și pentru curbă) sunt definite de macrodefinițiile:

- MOTOARE_VITEZA_MAX_MS;
- MOTOARE_VITEZA_CURBA_MS;

MOTOARE_VITEZA_MAX_MS = NR_INPUT_COEFF * MAX_VITEZA_MULTIPLIER ( 4.4 )

MOTOARE_VITEZA_CURBA_MS = NR_INPUT_COEFF * MIN_VITEZA_MULTIPLIER ( 4.5 )

- MAX_VITEZA_MULTIPLIER are valoarea 5.5;
- MIN_VITEZA_MULTIPLIER are valoarea 2.5;

## 4.8. PID

PID este un controller proporțional, derivativ și integrativ care are scopul de a minimiza eroarea unui semnal de intrare. Schema generală a unui PID este prezentată în următoarea figură.

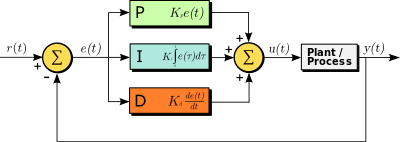
[picture p27: figure]
PID controller - Wikipedia

Fig. 4.13 Schemă PID

În cazul nostru, r(t) este viteza dorită, y(t) este viteza măsurată, u(t) este semnalul PWM al motoarelor, iar e(t) este eroarea. Întrucât avem un PID discret în cazul nostru, acesta este adaptat și are următoarea formulă:

u(n)=e(n)*KP+(e(n)-e(n-1))*(KD)/(TS)+ KI*TS*∑_0^n (e(n)+e(n-1))/2 ( 4.6 )

- TS, este perioada de la o iterație la alta și are valoarea de 0.125s;
- KP, este coeficientul părții proporționale și are valoarea 0.67;
- KI, este coeficientul părții integrative și are valoarea 0.0025;
- KD, este coeficientul părții derivative și are valoarea 0.0067.

Aceste valori au fost alese empiric după mai multe teste.

Fiecare coeficent afectează răspunsul sistemului într-un mod diferit. Componenta proporțională adaugă la răspuns o valoare proporțională cu eroarea. Acest lucru înseamnă că odată cu creșterea acestei componente, scade și timpul de răspuns al sistemului. Dezavantajul unui răspuns rapid este că poate duce la overshoot (ieșirea să fie prea mare) și poate duce la o eroare staționară. Alt dezavantaj este faptul că dacă coeficientul proporțional devine prea mare acest lucru poate duce la o instabilitate a sistemului.

Componenta integrativă are rolul de a micșora eroarea staționară. Această componentă calculează o sumă formată din erorile precedente înmulțite cu durata lor. Scopul este de a elimina eroarea staționară. Dezavantajul unei valori mari este că poate duce la un overshoot mare.

Componenta derivativă are rolul de a prezice comportamentul sistemului prin calcularea pantei dintre erori. Această componentă poate diminua overshootul și poate ajuta la stabilitatea sistemului când KD are valori mici, însă este foarte sensibilă la zgomot.

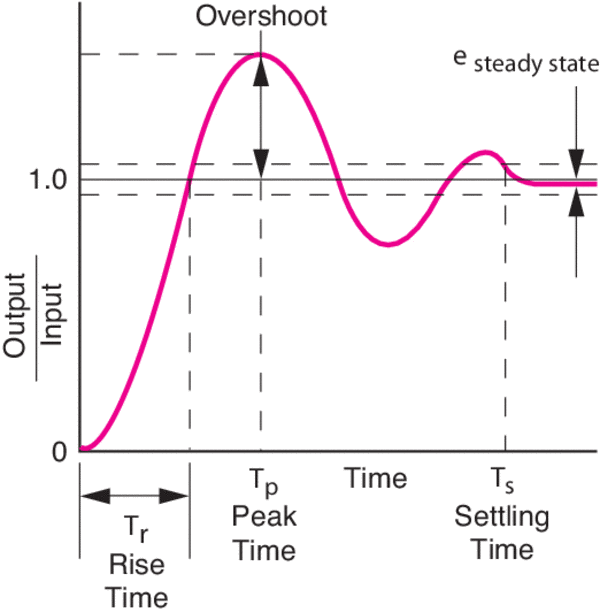
[picture p28: figure]

Fig. 4.14 PID, caracteristicile unui semnal

Pentru a seta factorului de umplere se calculează mai întâi turația, apoi viteza și în final folosind viteza actuală și cea cu o iterație în urmă, se calculează u(n). Se verifică semnul acestei valori și se ia execută următorii pași:

- Dacă semnul valorii u(n-1) este diferit de u(n), se setează factorul de umplere al semnalelor PWM la zero și se schimbă sensul de rotație al motoarelor;
- Se apelează funcția SetareViteza() cu parametrul u(n) sau –u(n), dacă u(n) are valoare negativă;
- Se reține semnul valorii u(n) pentru următoarea iterație.

Întrucât viteza este măsurată în incremenți de NR_INPUT_COEFF și nu se vor observa valori intermediare, dacă viteza măsurată este apropiată de cea dorită se va considera eroarea zero.

## 4.9. Ocolirea obstacolelor

Pentru a putea ocoli obstacolele s-au folosit trei senzori de distanță. Aceștia au nevoie de un semnal pentru a începe măsurătoarea, semnal care are perioada de 40ms și lățimea semnalului de 10us. Din momentul în care se începe măsurătoarea până în momentul în care se termină, semnalul ECHO va avea valoarea logică HIGH. În momentul în care semnalul ECHO are valoarea logică LOW, este activată o întrerupere (Pinul PTA17 pentru senzorul din mijloc, PTD7 pentru senzorul din dreapta, PTD6 pentru senzorul din stânga). Distanța se calculează conform următoarei formule:

distanta= (TIMP_PE_HIGH *(340m)/s)/2 ( 4.7 )

Întrucât nu putem măsura timpul direct, vom calcula o constantă care să aibă unitatea de măsură cm/count unde count reprezintă valoarea din registrul TPM0_CNT. Această constantă are următoarea formulă:

FACTOR_MUL_DISTANTA = ((340m)/s*(100cm)/m)/((1500000count)/s*2) =(0.01133cm)/(count) ( 4.8 )

- 340, este viteza sunetului;
- 100, este o constantă pentru a transforma din metri în centimetrii;
- 1500000, este valoarea pe care ar trebui să aibă TPM0_CNT pentru a avea perioada de o secundă;
- 2, este o constantă pentru a diviza distanța în două deoarece măsurătoarea include drumul dus-întors.

În final formula este rescrisă astfel:

distanta=TPM0_CNT *FACTOR_MUL_DISTANTA -DISTANTA_EROARE ( 4.9 )

- DISTANTA_EROARE este o macrodefiniție necesară pentru a corecta măsurătoarea și are valoarea 8.1cm. Eroarea apare deoarece există un delay până la începerea măsurătorii, vizibil în figura de mai jos (galben este semnalul TRIG, albastru este semnalul ECHO).

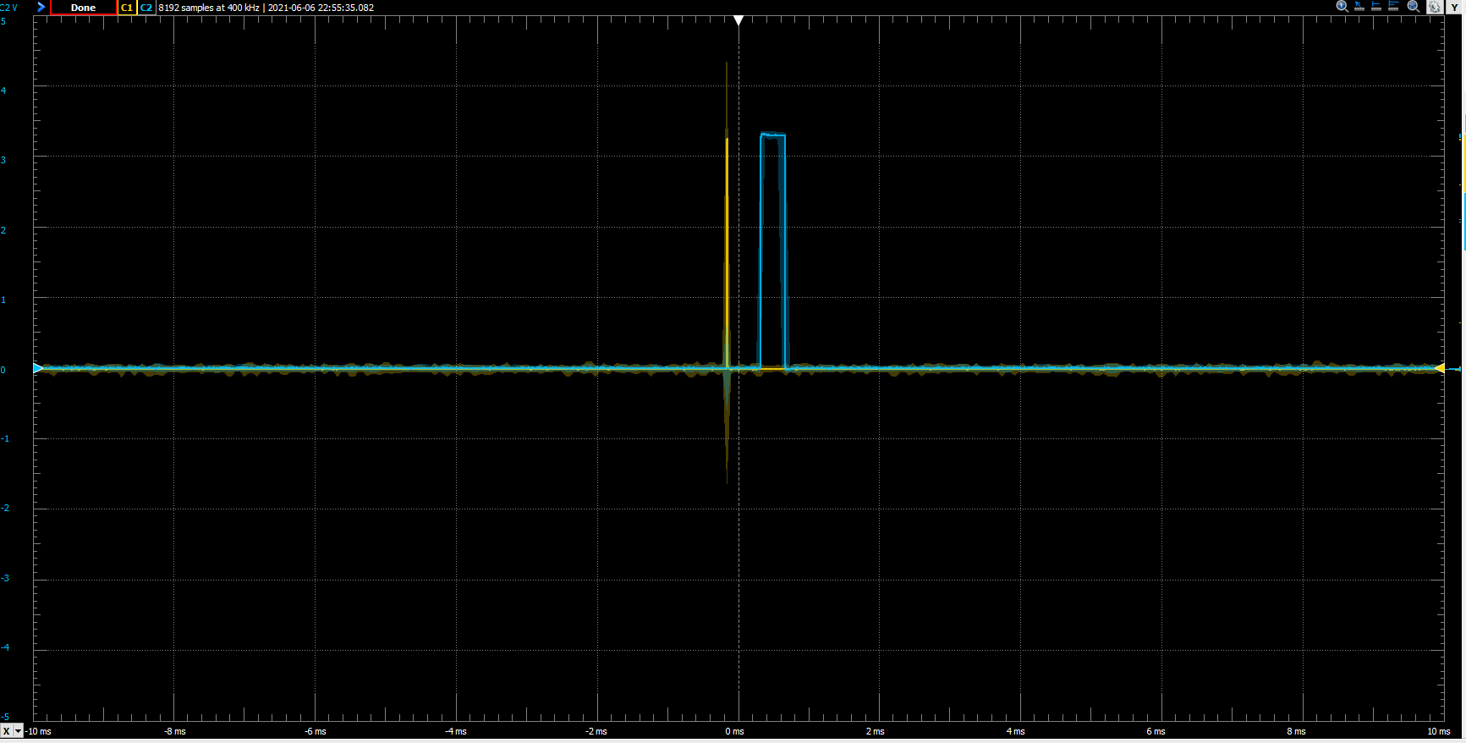
[picture p29: figure]

Fig. 4.15 Semnalele TRIG și ECHO

În momentul în care platforma măsoară o distanță mai mică decât DISTANTA_THRESHOLD (macrodefiniție care are valoarea 30) pe oricare dintre direcțiile stânga sau drepta sau o distanță pe direcția din mijloc mai mică decât DISTANTA_THRESHOLD_MIJLOC (macrodefiniție care are valoarea 45), platforma va urma pașii:

- Se intră în altă stare unde linia va fi ignorată;
- Se reduce viteza la valoarea MOTOARE_VITEZA_OBSTACOL;

MOTOARE_VITEZA_OBSTACOL = NR_INPUT_COEFF * MAX_VITEZA_OBS_MULTIPLIER ( 4.10 )

- MAX_VITEZA_OBS_MULTIPLIER are valoarea 1.75.
- Se verfică dacă există obstacole pe ambele direcții stânga și dreapta;
- Dacă da, se virează în direcția opusă față de obstacolul mai apropiat;
- Dacă există doar pe una din cele două direcții se virează direct în direcția opusă;
- Dacă nu mai există niciun obstacol, se virează puțin către direcția unde s-a aflat ultimul obstacol detectat și se revine la starea inițială cu detecția liniei.

# 5. Testare

## 5.1. Interacțiunea cu platforma

Întrucât nu avem o interfață grafică, testarea nu s-a desfășurat foarte rapid, fiind necesare ajustări mici, recompilarea codului și repornirea platformei de fiecare data. Pot fi urmărite anumite date cu ajutorul modulului Xbee sau direct prin conexiune serială la un PC cu ajutorul unor scripturi scrise în Matlab.

## 5.2. Diagrame UML

Modul în care utilizatorul interacționează cu platforma este reprezentat în diagrama de mai jos.

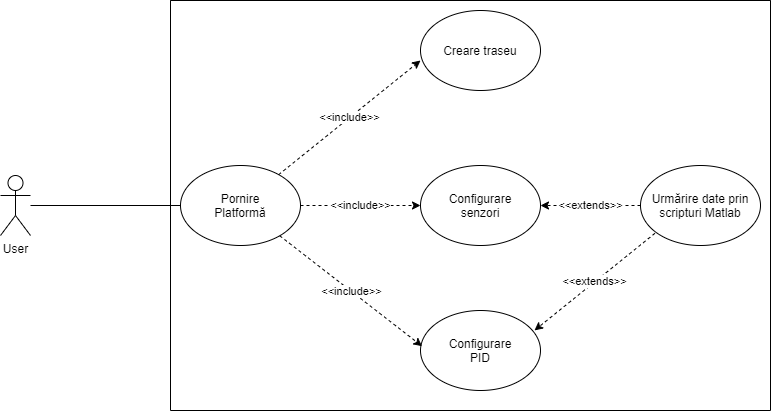
[picture p30: figure]

Fig. 5.1 Diagrama Use Case

În acest tip de diagrama, avem actorul, care în acest caz este utilizatorul platformei și următoarele stări:

- Pornire platformă, această stare reprezintă pornirea efectivă a platformei și plasarea acesteia pe traseu. Această stare nu poate fi de sine stătătoare având nevoie de stările Configurare senzori, Configurare PID și Creare Traseu;
- Creare Traseu, această stare reprezintă acțiunea fizică de a produce un traseu pe care platformă să îl parcurgă;
- Configurare senzori, această stare reprezintă configurarea parametrilor de threshold, a perioadelor pentru TPM, pentru a produce un comportament cât mai eficient și precis;
- Cpnfigurare PID, această stare reprezintă configurarea parametrilor KP, KD, KI, TS pentru pid pentru a putea duce la o accelerare și frânare cât mai rapidă și stabilă;
- Urmărire date prin scripturi de Matlab, această stare reprezintă urmărirea anumitor date trimise de către platformă cu ajutorul unei conexiuni seriale sau cu ajutorul modulelor XBee.

După ce utilizatorul a setat parametrii necesari, a construit traseul și a pornit alimentarea platformei, se vor inițializa toate driverele necesare, se vor inițializa variabilele corespunzător și din acest punct putem considera că platforma se va afla în una din două stări, cea în care platforma nu are niciun obstacol în cale (STATE_DRUM_FARA_OBSTACOL) și cea în care a fost detectat un obstacol pe una din cele trei direcții (STATE_DRUM_OBSTACOL). Diferența majoră dintre cele două stări este că în prima este luată linia în considerare în timp ce în a doua sunt luate în considerare doar obstacolele. Comportamentul este descris mai în detaliu în diagrama de activități de pe următoarea pagină.

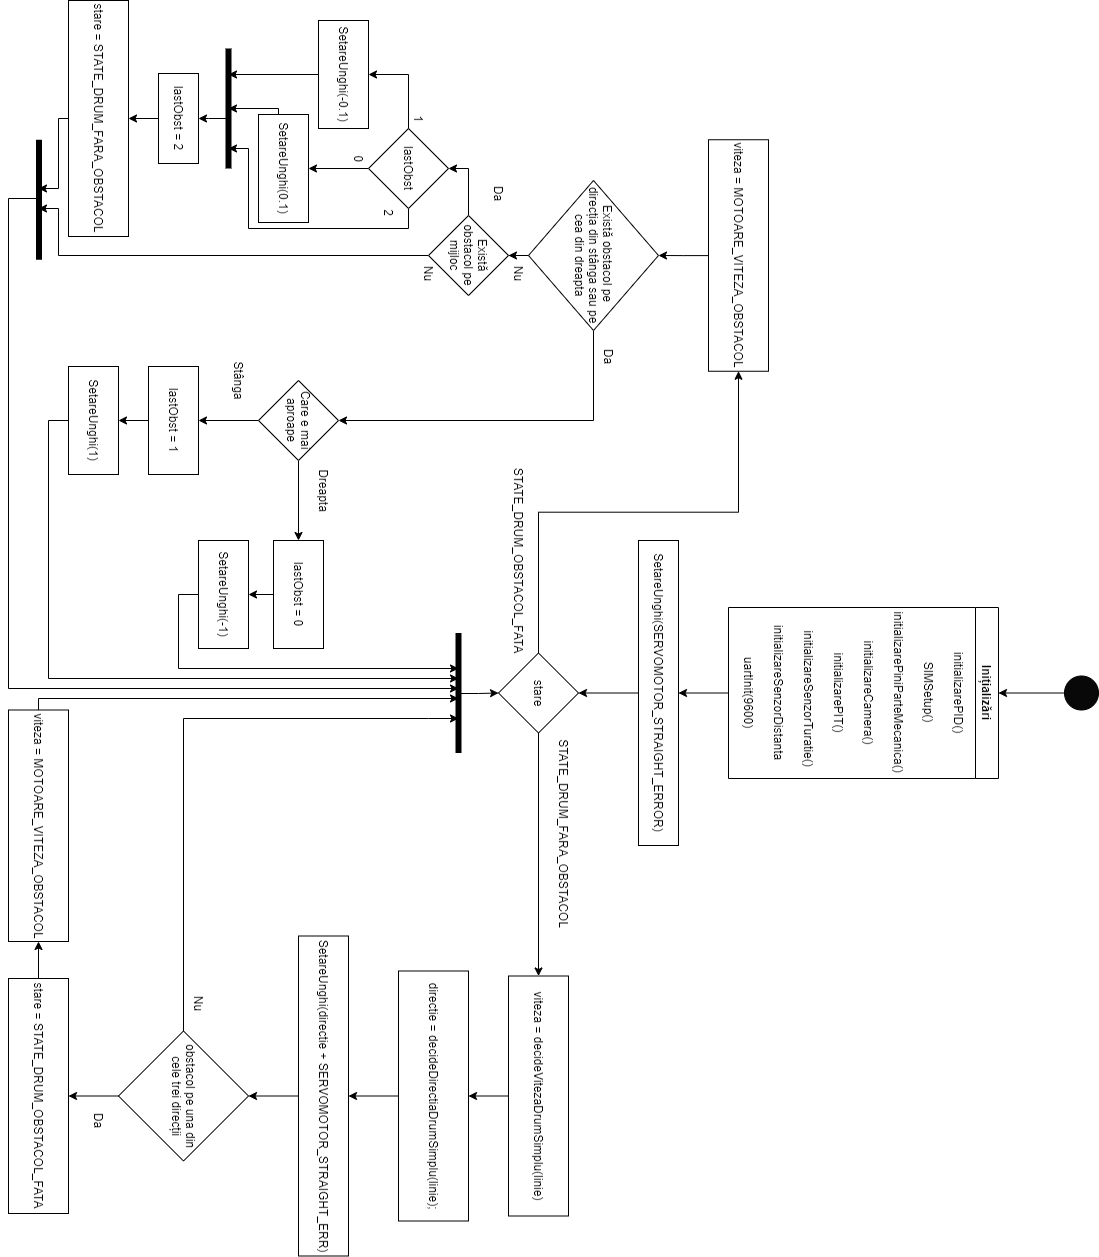
[picture p31: figure]

Fig. 5.2 Diagrama de activități

## 5.3. Testarea modulelor

Pentru a se testa modulele s-au folosit mai multe metode:

- Transmiterea datelor prin interfața serială direct la un PC, după care au fost interpretate în Matlab;
  - Avantajul este că datele sunt transmise rapid și există risc foarte mic se a se pierde unele din ele;
  - Dezavantajul este că platforma trebuie să fie conectată fizic la PC, iar variabilele de tip float sunt rotunjite.
- Transmiterea datelor prin serială către modulul XBee și după cu ajutorul celui de-al doilea modul XBee, către PC și în final datele au fost interpretate de Matlab;
  - Avantajul este că datele sunt transmise fără a exista o conexiune fizică;
  - Dezavantajul este că datele au o întârziere vizibilă, se pierd unele dintre ele, variabilele de tip float sunt rotunjite și sunt necesare configurări suplimentare folosind utilitarul X-CTU.
- Folosirea debug-ului din Keil µVision;
  - Avantajul este că datele sunt exact cele din memorie, se pot vedea regiștrii ce valori au, iar variabilele de tip float nu sunt rotunjite;
  - Dezavantajul este că platforma trebuie conectată fizic la PC, iar în momentul în care se dorește vizualizarea unei varibile, software-ul trebuie oprit temporar.
- Măsurarea cu ajutorul osciloscopului;
  - Avantajul este că putem observa semnalul dorit așa cum arată în realitate, putem vedea forma, tensiunea, perioada și factorul de umplere;
  - Dezavantajul este că în unele locuri nu este practică folosirea acestuia, cum ar fi verificarea caracterelor transmise pe interfața UART, întrucât ar trebui să decodificăm fiecare mesaj transmis.
- Observarea efectelor în practică ale modificărilor parametrilor.
  - Avantajul este că putem realiza acest lucru rapid, doar alimentând platforma la tensiune și că putem vedea și practic efectul schimbării anumitor parametrii. În general se vor întâlni situații în care datorită mediul înconjurător (nivelul de luminozitate, contrastul dintre linie și fundal, etc.) platforma nu se va comporta conform așteptărilor și în acest caz, este cel mai bine să observăm practic ce se întâmplă în diferite condiții;
  - Dezavantajul este că nu putem observa valorile interne ale platformei prin această metoda și dacă sunt corecte.

De cele mai multe ori s-au folosit conexiunea serială, măsurarea cu ajutorul osciloscopului și observarea efectelor în practică.

Pentru cameră inițial s-a folosit osciloscopul. A fost creat un script în Matlab care citește de la seriala platformei 128 de valori după care actualizează în figura generată graficul astfel încât să avem o imagine live (vezi Fig. 4.11). Portul pe care se realizează comunicarea este de obicei COM7 (COM4 pentru XBee), iar baud rate-ul este 9600.

Pentru senzorul de turație și PID s-a folosit comunicarea prin XBee și s-a observat efectul modificărilor parametrilor la comportamentul practic al platformei. Viteza are o valoare reală ceea ce înseamnă că la transmiterea de date se va pierde din precizie. Pentru a contracara acest lucru vom trimite doar numărul de magneți prezenți și vom înmulți fiecare valoare primită în scriptul de Matlab cu 0.2093.

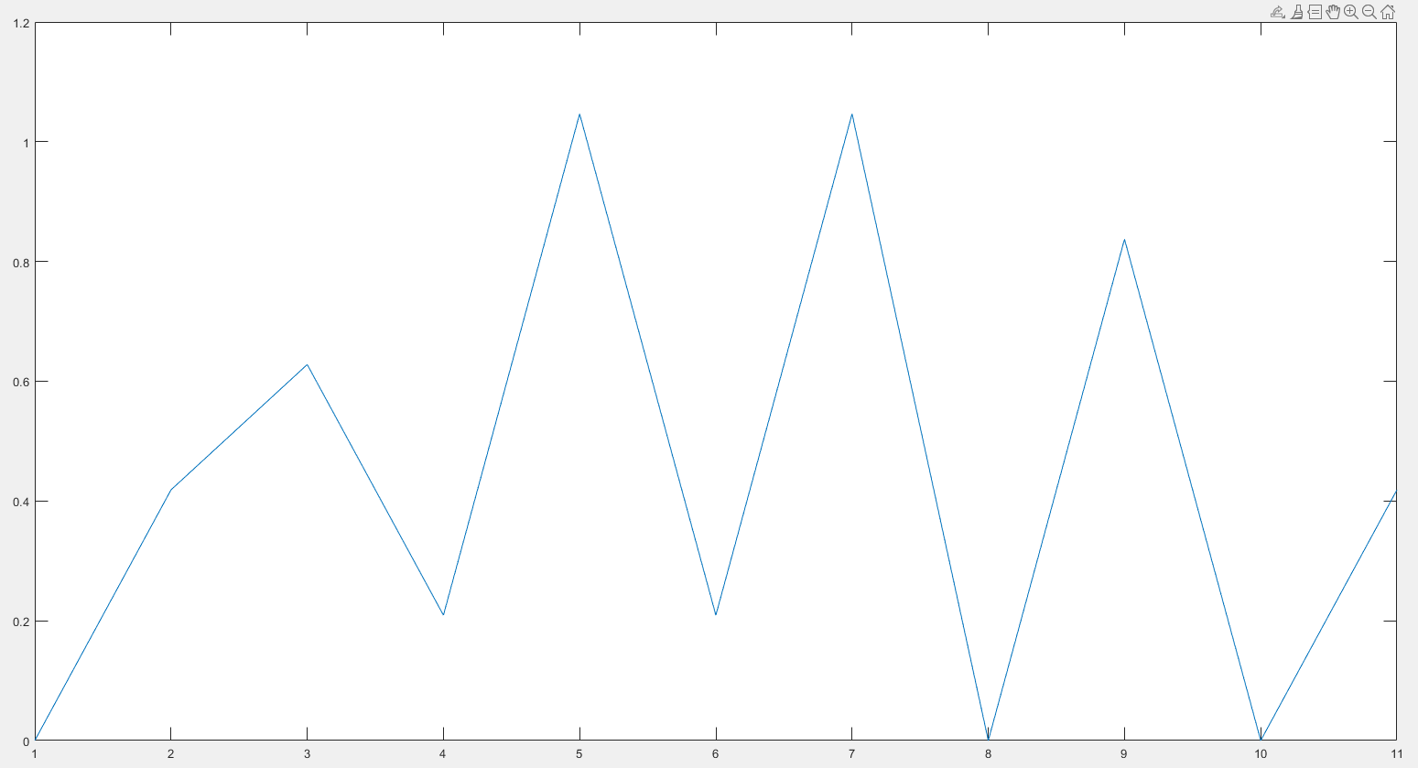
[picture p32: figure]

Fig. 5.3 Turația Matlab

În realitate platforma nu a avut niciodată, pe timpul acestei măsurători, viteza zero, dar datorită întârzierii adăugate de transmiterea de date și de probabilitatea de a nu nimeri un magnet la o măsurătoare și de-al nimeri la următoarea, graficul ajunge să aibă această formă. Pentru elimina din acest zgomot vom face o medie a punctelor apropiate. Acest semnal nou are o valoare mai apropiată de realitate.

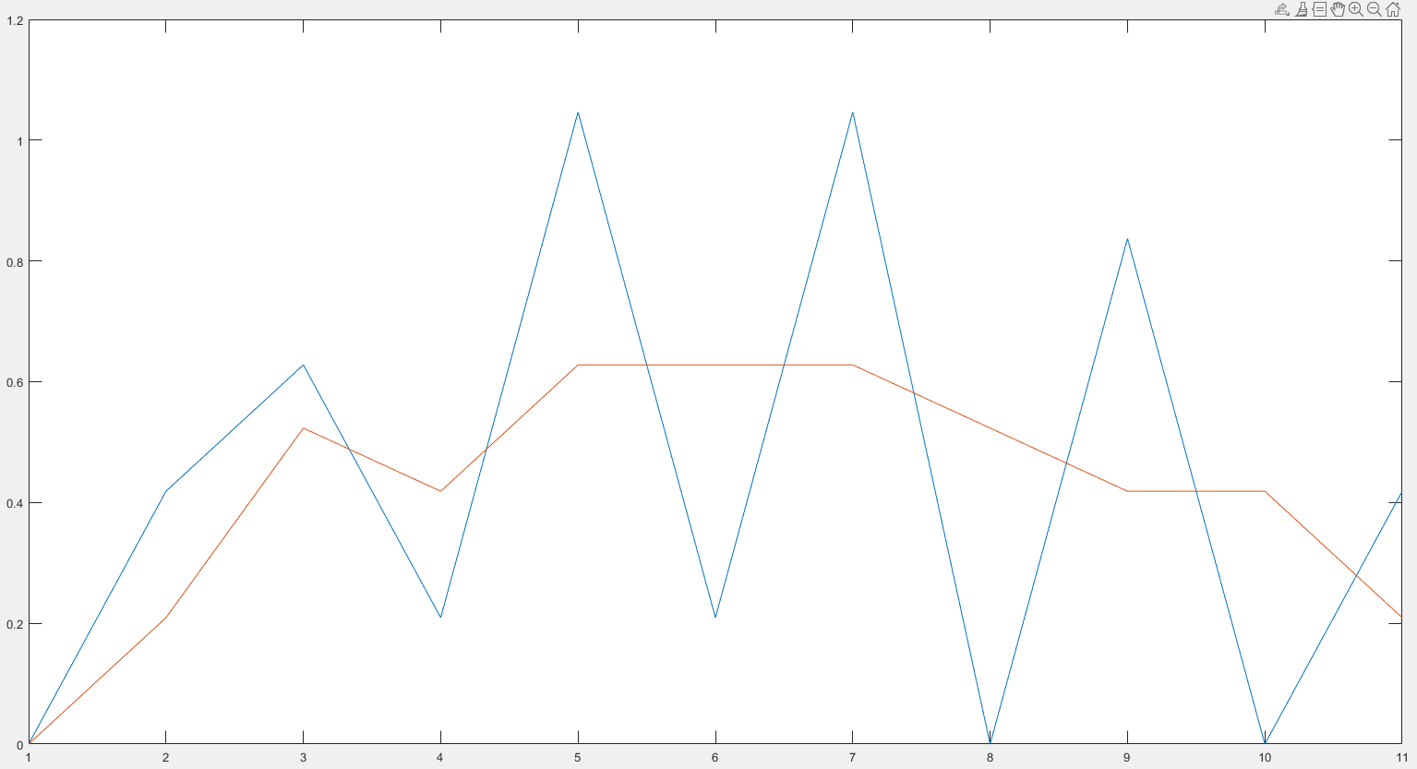
[picture p33: figure]

Fig. 5.4 Turația Matlab medie

În Fig. 5.4, semnalul cu culoarea portocalie este ceea ce a fost primit de la XBee, iar cel albastru este construit prin media punctelor apropiate.

Senzorii de distanță au fost testați cu ajutorul unui script în Matlab utilizând conexiunea serială a platformei și observați practic. Valorile obținute prin procesarea datelor de la senzorii de distanță sunt valori de tip float, însă nu avem nevoie de o precizie mai mică de un centimetru pentru această aplicație așa că datele sunt trimise direct pe interfața UART unde sunt transformate în numere naturale.

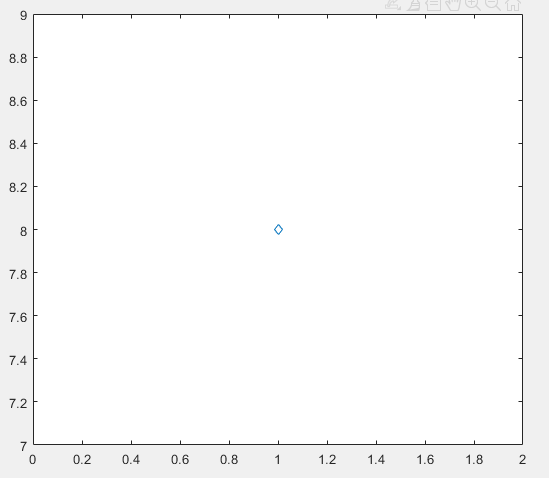
[picture p34: figure]

Fig. 5.5 Senzor distanță centru Matlab

În acest grafic se poate observa distanța față de senzorul de distanță de pe direcția centrală. Axa OX nu are nicio semnificație, iar pe axa OY la jumătate, în dreptul rombului, se află distanța față de un obstacol. Acest grafic se actualizează în timp real, schimbându-se doar valorile de pe OY.

# 6. Concluzii

Această platformă de dezvoltare s-a potrivit perfect cerințelor proiectului. Aplicația ,,bare-metal” a fost o modalitate foarte bună de a acumula cunoștințe legate de platformele de dezvoltare din seria Kinetis și de a învăța cum funcționează aceastea.

## 6.1. Probleme întâmpinate

Prima problemă întâmpinată a fost la configurarea pinilor. Inițial pinul PTA4 trebuia să fie folosit pentru canalul 1 al modulului TPM0 fiind mai aproape fizic de firul care duce la placa amplificatoare. Acest pin, însă, este preconfigurat și nu s-a reușit reconfigurarea lui ca pin pentru semnal PWM. În consecință a fost ales alt pin pentru a îndeplini această funcționalitate.

Următoarea problemă a fost întâmpinată la servomotor. Conexiunea fizică de la servomotor către roți se realizează cu ajutorul unor tije și a unui conector către o roată dințată care nu se potrivește perfect pentru a putea avea direcția înainte perfectă la un factor de umplere de 7.5%. Ca soluție la această problemă, în momentul în care se apelează funcția SetareUnghi() se adaugă, în general, un factor de corecție denumit SERVOMOTOR_STRAIGHT_ERR care este o macrodefiniție și are valoarea -0.07. De asemenea dacă platforma vira prea mult, roțile atingeau șasiul ceea ce ducea la o frânare a platformei. Această problemă a fost rezolvată limitând unghiul pe care funcția SetareUnghi() îl poate seta cu ajutorul macrodefiniției SERVOMOTOR_MAX_SIGNAL care are valoarea 0.4.

unghi= {, unghi, daca unghi ∊ (-0.4, 0.4), -0.4, dacă unghi ≤-0.4, 0.4, dacă unghi ≥0.4 ( 6.1 )

Alte două probleme întâmpinate sunt de natură mecanică. Modulul LineScanCamera este susținut fizic de patru șuruburi și două piulițe care datorita vibrațiilor provenite de la motoare, se desfac, iar cameră se rotește și nu mai este aliniată cu traseul. A doua problemă au fost magneții de pe roată, întrucât unul lipsea și măsurarea turației nu mai era precisă.

Pentru a ocoli obstacolele, senzorii de distanță transmit unde sonore care se reflectă asemănător cu undele electromagnetice. Acest lucru înseamnă că, ideal, ne dorim ca suprafața obstacolului să fie perpendiculară pe direcția de propagare a sunetului pentru a avea o probabilitate cât mai mare de a detecta reflexia. Întrucât platforma nu poate detecta obstacolul din anumite unghiuri, funcționalitatea de ocolire nu va funcționa mereu.

O problemă majoră a fost un scurtcircuit al servomotorului care ducea la supraîncălzirea siguranțelor termice F2 și F1, aflate pe driver-ul de motoare, încălzirea servomotorului și la un răspuns greu la semnalul de comandă sau chiar la niciun răspuns. Pentru a afla sursa problemei, s-a măsurat semnalul generat folosind un osciloscop. Acest lucru nu a dus la niciun rezultat și astfel, s-a înlocuit acesta cu totul moment în care problema supraîncălzirii siguranței F2 a fost rezolvată, problema siguranței termice F1 a fost ameliorată, iar servomotorul răspundea la comenzi. Siguranțele termice sunt prezentate în următoarele două figuri.

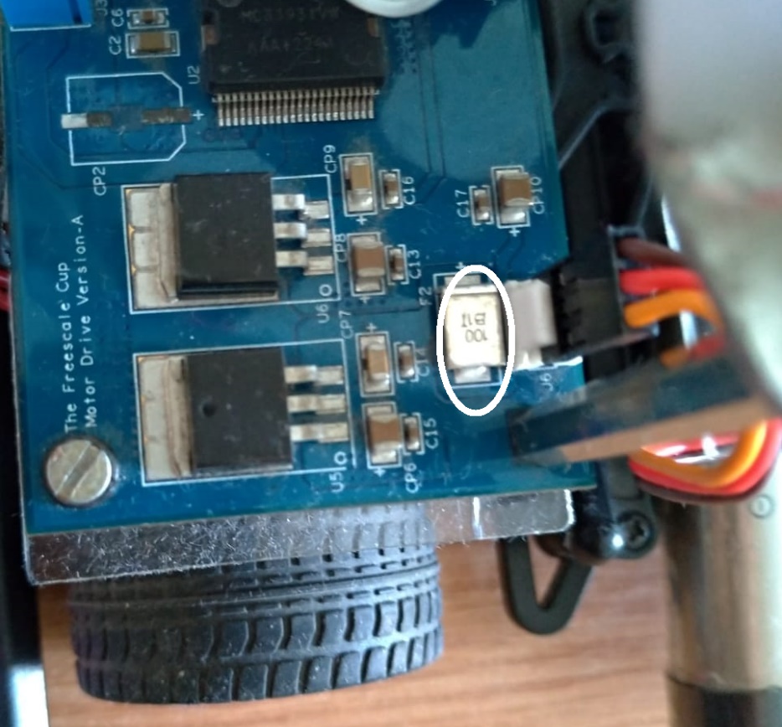
[picture p35: figure]

Fig. 6.1 Siguranța termică F2

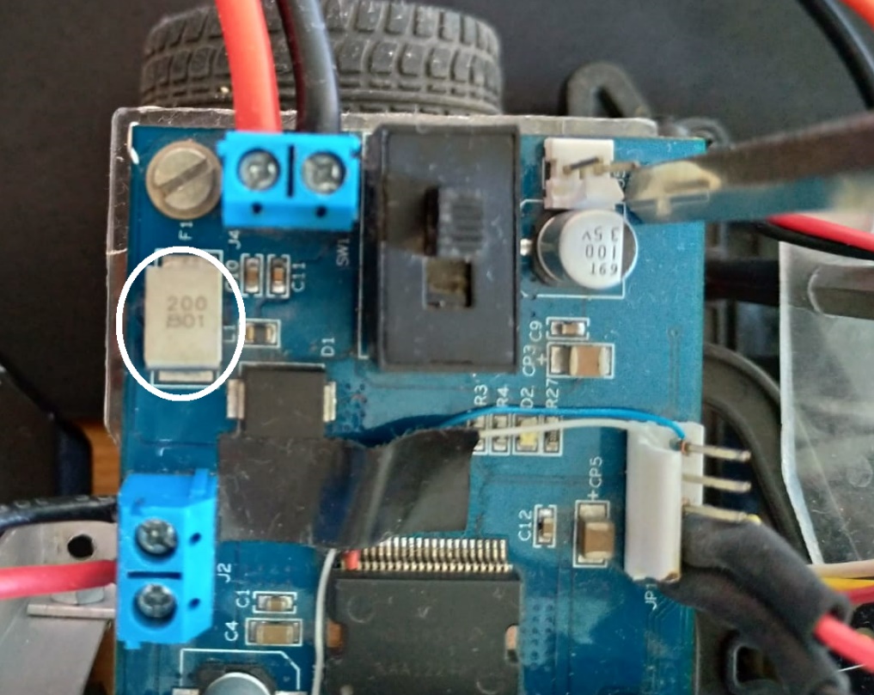
[picture p36: figure]

Fig. 6.2 Siguranța termică F1

Ultima problemă majoră a fost supraîncălzirea siguranței termice F1. Deși scurtcircuitul servomotorului a ajutat la încălzirea acesteia, nu a fost singura cauză. Puntea H responsabilă pentru motorul drept, încălzea prea puternic siguranța termică F1, ceea ce ducea la oprirea circuitului electric. Pentru a rezolva această problemă, deși avem semnale generate pentru două motoare, se va folosi doar puntea H responsabilă pentru motorul stâng.

# 7. Bibliografie

Dean, G. (2017). Embedded Systems Fundamentals with ARM Cortex-M based Microcontrollers, A Practical Aproach.

Grandpierre, T. (n.d.). Guide de de marrage et de de veloppement pour la NxP Cup.

Guoxiaoli. (n.d.). NXP community. Retrieved from https://community.nxp.com/t5/University-Programs-Knowledge/Line-Scan-Camera-Use/ta-p/1105313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

NXP. (2012 Rev. 3). KL25 Sub-Family Reference Manual.

SparkFun. (n.d.). SparkFun Learn. Retrieved from https://learn.sparkfun.com/tutorials/xbee-wifi-hookup-guide/all

SparkFun. (n.d.). Ultrasonic Ranging Module HC - SR04.

# 8. Anexe

## 8.1. Anexa 1

Această anexă cuprinde fisierul Defines.h care conține toate macrodefinițiile folosite.

#include "MKL25Z4.h"

/****************Pini Senzori Distanta****************/

#define PortSenzorDistantaTrig PORTD->PCR[4] //TPM0_CH4

#define PortSenzorDistantaTrigMux 4

#define PortSenzorDistantaEchoS PORTD->PCR[6]

#define PortSenzorDistantaSPin 6

#define PortSenzorDistantaEchoSM 1

#define PortSenzorDistantaEchoD PORTD->PCR[7]

#define PortSenzorDistantaDPin 7

#define PortSenzorDistantaEchoDM 1

#define PortSenzorDistantaEchoC PORTA->PCR[17]

#define PortSenzorDistantaCPin 17

#define PortSenzorDistantaEchoCM 1

/*****************Valori Senzor Distanta***************/

#define SENZOR_DISTANTA_PWM 0xF

#define FACTOR_MUL_DISTANTA 0.01133f //cm/percount

#define DISTANTA_EROARE 8.1f //cm

#define DISTANTA_THRESHOLD 30 //cm

#define DISTANTA_THRESHOLD_MIJLOC 45 //cm

/*****************Pini Senzor Turatie*****************/

#define PortSenzorTuratie PORTB->PCR[3] //TPM2_CH1

#define PortSenzorTuratieMux 3

#define SenzorTuratieMOD 0xB71B

/**************Valori Senzor Turatie******************/

#define NUMBER_OF_MAGNETS 6

#define DIAMETER_OF_WHEEL 0.05f // metri

#define PI 3.14f

#define COEFFICIENT_MEASURE_TIME 0.125f

#define NR_INPUT_COEFF (PI * DIAMETER_OF_WHEEL / COEFFICIENT_MEASURE_TIME) / NUMBER_OF_MAGNETS

/********************Pini Motor***********************/

#define PortMotorStanga PORTA->PCR[5] //TPM0_CH2

#define PortMotorDreapta PORTD->PCR[1] //TPM0_CH1

#define PortMotorActivareDreapta PORTD->PCR[2]

#define PortMotorActivareStanga PORTD->PCR[3]

#define PortSensMotor PORTD->PCR[5]

#define GPIODirMotorDreapta GPIOD_PDDR

#define GPIODirMotorStanga GPIOD_PDDR

#define GPIODirSensMotor GPIOD_PDDR

#define GPIOSMotorDreapta GPIOD_PSOR

#define GPIOSMotorStanga GPIOD_PSOR

#define GPIOSSensMotor GPIOD_PSOR

#define GPIOCMotorDreapta GPIOD_PCOR

#define GPIOCMotorStanga GPIOD_PCOR

#define GPIOCSensMotor GPIOD_PCOR

#define GPIOPinMotorDreapta 3

#define GPIOPinMotorStanga 2

#define GPIOPinSensMotor 5

#define PortMotorStangaMux 3

#define PortMotorDreaptaMux 4

#define PortMotorActivareDreaptaM 1

#define PortMotorActivareStangaM 1

#define PortSensMotorMux 1

#define MotorMaxCount 0x8CA0

/********************Valori Motor*********************/

#define MOTOARE_VITEZA_MAXIM_SIG 0.85f

#define SERVOMOTOR_MAXIM_SIG 0.4L

#define MOTOARE_SENS_INAITE 1

#define MOTOARE_SENS_SPATE -1

#define MAX_VITEZA_MULTIPLIER 5.5f

#define MIN_VITEZA_MULTIPLIER 2.5f

#define MAX_VITEZA_OBS_MULTIPLIER 1.75f

#define MOTOARE_VITEZA_MAX_MS NR_INPUT_COEFF * MAX_VITEZA_MULTIPLIER

#define MOTOARE_VITEZA_CURBA_MS NR_INPUT_COEFF * MIN_VITEZA_MULTIPLIER

#define MOTOARE_VITEZA_OBSTACOL NR_INPUT_COEFF * MAX_VITEZA_OBS_MULTIPLIER

/********************Pini ServoMotor******************/

#define PortServoMotor PORTA->PCR[12] //TPM1_CH0

#define PortServoMux 3

#define ServoMaxCount 0xEA60

#define ServoMinVal 0x5DC

#define ServoMaxVal 0x1D4C

/********************Valori Servomotor****************/

#define SERVOMOTOR_STRAIGHT_ERR -0.07f

#define SERVOMOTOR_MAX_SIGNAL 0.4L

#define SERVOMOTOR_THRESHOLD 12

/*********************Valori TPM**********************/

#define TPM_DIVIDER_SERVO 4

#define TPM_DIVIDER_TURATIE 7

#define TPM_DIVIDER_MOTOARE 5

#define TPMClockSource 1

#define TPMPLLFLLSELValue 0

/********************Pini Camera**********************/

#define PortAOCamera PORTB->PCR[0] //ADC0_SE8

#define PortAOCameraMux 0

#define PortSICamera PORTC->PCR[6]

#define PortSICameraMux 1

#define PortCLKCamera PORTC->PCR[7]

#define PortCLKCameraMux 1

#define GPIOPinSICamera 6

#define GPIOPinCLKCamera 7

#define GPIODirSICamera GPIOC_PDDR

#define GPIODirCLKCamera GPIOC_PDDR

#define GPIOSSICamera GPIOC_PSOR

#define GPIOSCLKCamera GPIOC_PSOR

#define GPIOCSICamera GPIOC_PCOR

#define GPIOCCLKCamera GPIOC_PCOR

#define GPIOTCLKCamera GPIOC_PTOR

/******************Valori pentru camera***************/

#define NUMBER_OF_CLOCKS 256

#define PIT_HALF_CLOCK 0x8FF

#define PIT_QUARTER_CLOCK PIT_HALF_CLOCK/2

#define PIT_SI_CLOCK PIT_HALF_CLOCK*(256+8)

#define CAMERA_START 0

#define CAMERA_SET_CLK 1

#define CAMERA_CLEAR_SI 2

#define CAMERA_FINAL 3

#define CAMERA_IGNORE_EDGE_VAL 12

#define LINE_MAX_ERROR_FOR_SPEED 5

/*********************Pini ADC************************/

#define ADCCameraResult ADC0_RA

#define ADCCameraCFG1 ADC0_CFG1

#define ADCCameraCFG2 ADC0_CFG2

#define ADCCameraPG ADC0_PG

#define ADCCameraMG ADC0_MG

#define ADCCameraSC1A ADC0_SC1A

#define ADCCameraSC1B ADC0_SC1B

#define ADCCameraSC1 ADC0_SC1

#define ADCCameraSC2 ADC0_SC2

#define ADCCameraSC3 ADC0_SC3

/************************PID**************************/

#define PID_TS COEFFICIENT_MEASURE_TIME

#define PID_KP 0.67f

#define PID_KI 0.0025f

#define PID_KD 0.0067f

/**********************Pini UART**********************/

#define PortUartRX PORTA->PCR[1]

#define PortUartTX PORTA->PCR[2]

#define PortUartRXMux 2

#define PortUartTXMux 2

/********************Valori UART**********************/

#define BUS_CLOCK DEFAULT_SYSTEM_CLOCK

/***********************Debug*************************/

#define CAMERA_DEBUG_LINE_SCAN 0

#define SENZOR_TUR_SEMNAL_DEBUG 0

#define SENZOR_DISTANTA_DEBUG_S 0

#define SENZOR_DISTANTA_DEBUG_D 0

#define SENZOR_DISTANTA_DEBUG_C 0

#define DEZACTIVARE_PID_DEBUG 0

#define DEZACTIVARE_MODUL_DIST 0

#define CAMERA_EDGE_VAL 0xFF

/***********************Stari************************/

#define STATE_DRUM_FARA_OBSTACOL 0

#define STATE_DRUM_OBSTACOL 1

## 8.2. Anexa 2

Această anexă conține codul fișierului Main.c.

#include "MKL25Z4.h"

#include "Motoare.h"

#include "PortsSetup.h"

#include "Camera.h"

#include "SistemDecizional.h"

#include "SenzoriDistanta.h"

#include "Uart.h"

#include "PID.h"

extern uint8_t linie;

extern float volatile viteza;

extern float volatile distantaS;

extern float volatile distantaD;

extern float volatile distantaC;

uint8_t lastObst = 2;

static uint8_t stare = STATE_DRUM_FARA_OBSTACOL;

static long double directie;

int main (void) {

//Se initializeaza toate modulele si variabilele necesare

directie = 0;

SIMSetup();

initializarePID(PID_TS, PID_KP, PID_KI, PID_KD);

InitializarePiniParteMecanica();

initializareCamera();

initializarePIT();

initializareSenzorTuratie();

initializareSenzoriDistanta();

startCamera();

//9900 pentru XBEE, 115200 pentru UART prin cablu

uartInit(9600);

//Unghiul initial este de 0 grade

SetareUnghi(SERVOMOTOR_STRAIGHT_ERR);

for(int i=0;i<10000000;i++){

viteza = 0;

}

while(1){

switch(stare)

{

case STATE_DRUM_FARA_OBSTACOL:

viteza = decideVitezaDrumSimplu(linie);

directie = decideDirectiaDrumSimplu(linie);

SetareUnghi(directie + SERVOMOTOR_STRAIGHT_ERR);

//Daca dorim sa nu folosim functionalitatea de ocolire de obstacole se poate seta macrodefinitia la valoarea 1

#if (DEZACTIVARE_MODUL_DIST == 0)

if(distantaC<DISTANTA_THRESHOLD_MIJLOC || distantaD < DISTANTA_THRESHOLD || distantaS < DISTANTA_THRESHOLD)

{

stare = STATE_DRUM_OBSTACOL;

viteza = 0;

}

#endif

break;

#if (DEZACTIVARE_MODUL_DIST == 0)

case STATE_DRUM_OBSTACOL:

viteza = MOTOARE_VITEZA_OBSTACOL;

//Daca avem obstacol pe laterale ne departam de cel mai apropiat

if(distantaD < DISTANTA_THRESHOLD || distantaS < DISTANTA_THRESHOLD)

{

if(distantaD < distantaS)

{

lastObst = 0;

SetareUnghi(-1);

}

else

{

lastObst = 1;

SetareUnghi(1);

}

break;

}

directie = decideDirectiaDrumSimplu(linie);

SetareUnghi(directie + SERVOMOTOR_STRAIGHT_ERR);

//Daca nu avem niciun obstacol pe nicio directie se revine la detectarea liniei si mentinerea drumului

if(distantaC > DISTANTA_THRESHOLD_MIJLOC)

{

if(lastObst == 0)

SetareUnghi(0.1f);

if(lastObst == 1)

SetareUnghi(-0.1f);

stare = STATE_DRUM_FARA_OBSTACOL;

lastObst = 2;

}

break;

#endif

default:

break;

}

}

}

## 8.3. Anexa 3

Această anexă conține codul fișierului Motoare.c.

#include "Motoare.h"

#include "Uart.h"

#include "PID.h"

float volatile vitezaCurenta = 0;

float volatile viteza=0;

float volatile semnal=0;

uint16_t volatile nrInput = 0;

uint8_t volatile lastSign = 0;

double abs(double x)

{

if(x<0)

return -x;

return x;

}

void TPM2_IRQHandler(void)

{

NVIC_ClearPendingIRQ(TPM2_IRQn);

//Verificam daca intreruperea a fost generata de catre modul input capture

if(TPM2->CONTROLS[1].CnSC & TPM_CnSC_CHF_MASK)

{

nrInput++;

TPM2->CONTROLS[1].CnSC |= TPM_CnSC_CHF_MASK;

}

//Verificam daca modulul a terminat de numarat

if((TPM2_SC & TPM_SC_TOF_MASK))

{

//Calculam viteza

vitezaCurenta = nrInput*NR_INPUT_COEFF;

TPM2_SC |= TPM_SC_TOF_MASK;

//Daca PID-ul nu este dezactivat calculam semnalul urmator

if(DEZACTIVARE_PID_DEBUG == 0)

{

if(abs(viteza - vitezaCurenta)<NR_INPUT_COEFF/5)

{

vitezaCurenta = viteza;

}

//Daca masina trebuie sa se opreasca si viteza ajunge la 0 semnalul trebuie sa ramana pe 0

if(viteza == 0 && vitezaCurenta == 0)

semnal = 0;

else

semnal = getNextPid(viteza, vitezaCurenta);

//PID-ul ne poate da valori mai mari decat 1 sau mai mici decat -1 si nu dorim acest lucru

if(semnal > 1)

semnal = 1;

if(semnal < -1)

semnal = -1;

//In functie de semnul variabilei semnal schimbam sensul motoarelor

if(semnal < 0)

{

if(lastSign == 0)

SetareViteza(0);

SetareSens(MOTOARE_SENS_SPATE);

SetareViteza(-semnal);

lastSign = 1;

}

else

{

if(lastSign == 1)

SetareViteza(0);

SetareSens(MOTOARE_SENS_INAITE);

SetareViteza(semnal);

lastSign = 0;

}

}

//Pentru a face debug pe semnal trimitem prin XBEE valoarea

#if (SENZOR_TUR_SEMNAL_DEBUG == 1)

trimiteDate(nrInput);

#endif

//Resetam numarul de inputuri

nrInput = 0;

}

}

void InitializarePiniParteMecanica(void){

//Setare multiplexor pentru porturi

PortMotorDreapta |= PORT_PCR_MUX(PortMotorDreaptaMux);

PortMotorStanga |= PORT_PCR_MUX(PortMotorStangaMux);

PortMotorActivareDreapta |= PORT_PCR_MUX(PortMotorActivareDreaptaM);

PortMotorActivareStanga |= PORT_PCR_MUX(PortMotorActivareStangaM);

PortSensMotor |= PORT_PCR_MUX(PortSensMotorMux);

PortServoMotor |= PORT_PCR_MUX(PortServoMux);

//Configurare pini GPIO

PortMotorActivareDreapta |= PORT_PCR_PE(1) & (~PORT_PCR_PS(1));

PortMotorActivareStanga |= PORT_PCR_PE(1) & (~PORT_PCR_PS(1));

PortSensMotor |= PORT_PCR_PE(1) & (~PORT_PCR_PS(1));

GPIODirMotorDreapta |= 1<<GPIOPinMotorDreapta;

GPIODirMotorStanga |= 1<<GPIOPinMotorStanga;

GPIODirSensMotor |= 1<<GPIOPinSensMotor;

GPIOSMotorDreapta |= 1<<GPIOPinMotorDreapta;

GPIOSMotorStanga |= 1<<GPIOPinMotorStanga;

GPIOCSensMotor |= 1<<GPIOPinSensMotor;

//Setare divizor frecventa

TPM0->SC |= TPM_SC_PS(TPM_DIVIDER_MOTOARE);

TPM1->SC |= TPM_SC_PS(TPM_DIVIDER_SERVO);

//Setare mod de numarare

TPM0->SC &= ~TPM_SC_CPWMS_MASK;

TPM1->SC &= ~TPM_SC_CPWMS_MASK;

//Setare modulo

TPM0->CNT = 0;

TPM0->MOD = MotorMaxCount;

TPM1->CNT = 0;

TPM1->MOD = ServoMaxCount;

//Setare mod Edge-Aligned PMW

TPM1->CONTROLS[0].CnSC = TPM_CnSC_MSB_MASK | TPM_CnSC_ELSB_MASK;

TPM0->CONTROLS[2].CnSC = TPM_CnSC_MSB_MASK | TPM_CnSC_ELSB_MASK;

TPM0->CONTROLS[1].CnSC = TPM_CnSC_MSB_MASK | TPM_CnSC_ELSB_MASK;

//Setare mod trigger

TPM0->CONF |= TPM_CONF_TRGSEL(0x8);

TPM1->CONF |= TPM_CONF_TRGSEL(0x9);

//Setare factor de umplere

TPM1->CONTROLS[0].CnV = ServoMaxCount*0.075f;

TPM0->CONTROLS[2].CnV = 0;

TPM0->CONTROLS[1].CnV = 0;

//Activare TPM

TPM0->SC |= TPM_SC_CMOD(1);

TPM1->SC |= TPM_SC_CMOD(1);

}

void initializareSenzorTuratie(void)

{

PortSenzorTuratie |= PORT_PCR_MUX(PortSenzorTuratieMux);

PortSenzorTuratie |= PORT_PCR_PE(1) & (~PORT_PCR_PS(1));

//Setare divizor frecventa

TPM2->SC |= TPM_SC_PS(TPM_DIVIDER_TURATIE);

//Setare mod de numarare

TPM2->SC &= ~TPM_SC_CPWMS_MASK;

TPM2->SC |= TPM_SC_TOIE_MASK;

//Setare modulo

TPM2->CNT = 0;

TPM2->MOD = SenzorTuratieMOD;

//Setare trigger

TPM2->CONF |= TPM_CONF_TRGSEL(0xA);

//Setare mod input capture

TPM2->CONTROLS[1].CnSC = TPM_CnSC_ELSB_MASK | TPM_CnSC_CHIE_MASK;

//Activare intrerupere

NVIC_SetPriority(TPM2_IRQn, 128);

NVIC_ClearPendingIRQ(TPM2_IRQn);

NVIC_EnableIRQ(TPM2_IRQn);

TPM2->SC |= TPM_SC_CMOD(1);

}

void SetareSens(int sens)

{

if(sens == MOTOARE_SENS_INAITE) // Setare sens inainte

{

GPIOCSensMotor |= 1<<GPIOPinSensMotor;

}

else if(sens == MOTOARE_SENS_SPATE) // Setare sens inapoi

{

GPIOSSensMotor |= 1<<GPIOPinSensMotor;

} //Daca nu este niciuna dintre ele nu se modifica sensul

}

void SetareViteza(float vitezaMotor)

{

//Daca viteza este in afara intervalului dorit se limiteaza

if(vitezaMotor < 0)

vitezaMotor = 0;

if(vitezaMotor > MOTOARE_VITEZA_MAXIM_SIG)

vitezaMotor = MOTOARE_VITEZA_MAXIM_SIG;

//Setam viteza corespunzator

TPM0->CONTROLS[2].CnV = MotorMaxCount*vitezaMotor;

TPM0->CONTROLS[1].CnV = MotorMaxCount*vitezaMotor;

}

void SetareUnghi(long double unghi)

{

//Intrucat la valoarea 0 platforma nu va mentine rotile fix drepte ne folosim de un factor de eroare

if(unghi == 0)

{

unghi = SERVOMOTOR_STRAIGHT_ERR;

return;

}

//Se limiteaza valorile posibile intrucat platforma nu poate vira la valori foarte mari sau mici

if(unghi<-SERVOMOTOR_MAX_SIGNAL)

{

unghi = -SERVOMOTOR_MAX_SIGNAL;

}

if (unghi > SERVOMOTOR_MAX_SIGNAL)

{

unghi = SERVOMOTOR_MAX_SIGNAL;

}

//Se calculeaza un procent

unghi++;

unghi /= 2;

unghi = (ServoMaxVal-ServoMinVal)*unghi;

unghi = unghi + ServoMinVal;

//Se seteaza valoarea calculata

TPM1->CONTROLS[0].CnV = unghi;

}

## 8.4. Anexa 4

Această anexă conține codul fișierului PortsSetup.c.

#include "MKL25Z4.h"

#include "PortsSetup.h"

void SIMSetup(void)

{

//Setare biti in registrii SIM pentru ceasuri

SIM->SCGC5 |= SIM_SCGC5_PORTA_MASK;

SIM->SCGC5 |= SIM_SCGC5_PORTB_MASK;

SIM->SCGC5 |= SIM_SCGC5_PORTC_MASK;

SIM->SCGC5 |= SIM_SCGC5_PORTD_MASK;

SIM->SCGC5 |= SIM_SCGC5_PORTE_MASK;

SIM->SCGC6 |= SIM_SCGC6_TPM0_MASK;

SIM->SCGC6 |= SIM_SCGC6_TPM1_MASK;

SIM->SCGC6 |= SIM_SCGC6_TPM2_MASK;

SIM->SCGC6 |= SIM_SCGC6_ADC0_MASK;

SIM->SCGC6 |= SIM_SCGC6_PIT_MASK;

//Configurare ceas TPM

SIM->SOPT2 |= SIM_SOPT2_TPMSRC(TPMClockSource);

SIM->SOPT2 &=~(SIM_SOPT2_PLLFLLSEL(TPMPLLFLLSELValue));

}

## 8.5. Anexa 5

Această anexă conține codul fișierului Camera.c.

#include "Camera.h"

#include "Uart.h"

#include "SistemDecizional.h"

#include "Motoare.h"

static volatile uint8_t cameraState=0;

static volatile uint32_t clockCycles=0;

static volatile uint8_t min;

static volatile uint8_t linieStatus = 63;

volatile uint8_t linie=63;

#if (CAMERA_DEBUG_LINE_SCAN == 1)

static volatile uint8_t tempPixels[128];

static void debugLineScanCamera(void)

{

//Functie de debug pentru camera, se foloseste cu scriptul din Matlab

register uint8_t i=0;

tempPixels[0] = CAMERA_EDGE_VAL;

tempPixels[127] = CAMERA_EDGE_VAL;

tempPixels[CAMERA_IGNORE_EDGE_VAL] = CAMERA_EDGE_VAL-0x10;

tempPixels[127-CAMERA_IGNORE_EDGE_VAL] = CAMERA_EDGE_VAL-0x10;

for(i=0;i<128;i++)

trimiteDate(tempPixels[i]);

}

#else

static void debugLineScanCamera(void)

{

return;

}

#endif

void ADC0_IRQHandler(void)

{

uint8_t value;

ADCCameraSC1A &= ~ADC_SC1_AIEN_MASK;

value =(uint8_t)ADCCameraResult;

//Nu ne intereseaza marginea drumului intrucat ar putea sa fie din afara traseului si sa introduca erori

if(clockCycles < NUMBER_OF_CLOCKS && clockCycles/2>CAMERA_IGNORE_EDGE_VAL && clockCycles/2<127-CAMERA_IGNORE_EDGE_VAL)

{

#if (CAMERA_DEBUG_LINE_SCAN == 1)

tempPixels[clockCycles/2] = (uint8_t)value;

#endif

if(min<(uint8_t)value)

{

linieStatus = clockCycles/2;

min = value;

}

}

}

void PIT_IRQHandler(void)

{

NVIC_ClearPendingIRQ(PIT_IRQn);

if(PIT->CHANNEL[0].TFLG & PIT_TFLG_TIF_MASK)

{

PIT_TCTRL0 = 0;

PIT_TCTRL1 = 0;

//Functie pentru a lua datele de la camera, aceasta are mai multe stari in functie de ce semnale se genereaza

switch(cameraState)

{

case CAMERA_START:

GPIOCCLKCamera = 1<<GPIOPinCLKCamera;

debugLineScanCamera();

linie = linieStatus;

GPIOSSICamera = 1<<GPIOPinSICamera;

clockCycles = 1;

cameraState = CAMERA_SET_CLK;

PIT->CHANNEL[0].LDVAL = PIT_QUARTER_CLOCK;

min = 0x0;

break;

case CAMERA_SET_CLK:

GPIOSCLKCamera |= 1<<GPIOPinCLKCamera;

cameraState = CAMERA_CLEAR_SI;

break;

case CAMERA_CLEAR_SI:

GPIOCSICamera |= 1<<GPIOPinSICamera;

cameraState = CAMERA_FINAL;

break;

case CAMERA_FINAL:

GPIOCCLKCamera |= 1<<GPIOPinCLKCamera;

PIT->CHANNEL[0].LDVAL = PIT_SI_CLOCK;

ADCCameraSC1A = ADC_SC1_ADCH(8) | ADC_SC1_AIEN_MASK;

PIT->CHANNEL[1].TCTRL = PIT_TCTRL_TEN_MASK | PIT_TCTRL_TIE_MASK;

cameraState = CAMERA_START;

break;

}

PIT->CHANNEL[0].TFLG &= PIT_TFLG_TIF_MASK;

PIT->CHANNEL[1].TFLG &= PIT_TFLG_TIF_MASK;

PIT->CHANNEL[0].TCTRL = PIT_TCTRL_TEN_MASK | PIT_TCTRL_TIE_MASK;

}

else if(PIT->CHANNEL[1].TFLG & PIT_TFLG_TIF_MASK)

{

//Aici se genereaza clockul pentru camera

if(clockCycles%2 == 0)

ADCCameraSC1A = ADC_SC1_ADCH(8) | ADC_SC1_AIEN_MASK;

PIT->CHANNEL[1].TFLG &= PIT_TFLG_TIF_MASK;

GPIOTCLKCamera |= 1<<GPIOPinCLKCamera;

clockCycles++;

}

}

void startCamera(void)

{

//Se porneste modulul PIT pentru camera

PIT_MCR &= ~(PIT_MCR_MDIS_MASK);

PIT_LDVAL0 = PIT_QUARTER_CLOCK;

PIT_LDVAL1 = PIT_HALF_CLOCK;

PIT_TCTRL0 = PIT_TCTRL_TEN_MASK | PIT_TCTRL_TIE_MASK;

PIT_MCR = 1;

cameraState = CAMERA_START;

}

void initializarePIT(void)

{

//Se activeaza modulul

PIT->MCR &= ~PIT_MCR_MDIS_MASK;

//Se configureaza canalul 0

PIT->CHANNEL[0].LDVAL = PIT_LDVAL_TSV(PIT_HALF_CLOCK);

PIT->CHANNEL[0].TCTRL &= PIT_TCTRL_CHN_MASK;

PIT->CHANNEL[0].TCTRL |= PIT_TCTRL_TIE_MASK;

//Se seteaza intrerupea

NVIC_SetPriority(PIT_IRQn, 128);

NVIC_ClearPendingIRQ(PIT_IRQn);

NVIC_EnableIRQ(PIT_IRQn);

}

void initializareCamera(void)

{

//Configurare pini CLK si SI

PortSICamera |= PORT_PCR_MUX(PortSICameraMux);

PortCLKCamera |= PORT_PCR_MUX(PortCLKCameraMux);

PortSICamera |= PORT_PCR_PE(1) & (~PORT_PCR_PS(1));

PortCLKCamera |= PORT_PCR_PE(1) & (~PORT_PCR_PS(1));

//Configurare pini GPIO

GPIODirSICamera |= 1<<GPIOPinSICamera;

GPIODirCLKCamera |= 1<<GPIOPinCLKCamera;

GPIOSCLKCamera |= 1<<GPIOPinCLKCamera;

GPIOCSICamera |= 1<<GPIOPinSICamera;

//Configurare pin pentru AO

PortAOCamera |= PORT_PCR_MUX(PortAOCameraMux);

//Se verifica calibrarea

if(calibrareADC()==-1)

return;

ADCCameraCFG1 = 0;

ADCCameraCFG2 = 0;

ADCCameraSC1A = 0x1F;

ADCCameraSC2 = 0;

ADCCameraSC3 &= 0xF;

NVIC_SetPriority(ADC0_IRQn, 128);

NVIC_ClearPendingIRQ(ADC0_IRQn);

NVIC_EnableIRQ(ADC0_IRQn);

}

static int calibrareADC(void)

{

//Functie de calibrare a ADC-ului, pentru detalii vedeti in reference manual

uint16_t calVar;

ADCCameraSC2 &= ~ADC_SC2_ADTRG_MASK;

ADCCameraSC3 &= (~ADC_SC3_ADCO_MASK & ~ADC_SC3_AVGS_MASK);

ADCCameraSC3 |= ADC_SC3_AVGE_MASK | ADC_SC3_AVGS(3);

ADCCameraSC3 |= ADC_SC3_CAL_MASK;

while(!(ADCCameraSC1A & ADC_SC1_COCO_MASK));

if(ADCCameraSC3 & ADC_SC3_CALF_MASK)

return -1;

calVar = 0;

calVar +=ADC0_CLP0;

calVar +=ADC0_CLP1;

calVar +=ADC0_CLP2;

calVar +=ADC0_CLP3;

calVar +=ADC0_CLP4;

calVar +=ADC0_CLPS;

calVar /= 2;

calVar |= 0x8000;

ADCCameraPG = ADC_PG_PG(calVar);

calVar = 0;

calVar += ADC0_CLM0;

calVar += ADC0_CLM1;

calVar += ADC0_CLM2;

calVar += ADC0_CLM3;

calVar += ADC0_CLM4;

calVar += ADC0_CLMS;

calVar /= 2;

calVar |= 0x8000;

ADCCameraMG = ADC_MG_MG(calVar);

ADCCameraSC3 &= ~(ADC_SC3_CAL_MASK);

return 0;

}

## 8.6. Anexa 6

Această anexă conține codul fișierului SistemDecizional.c.

#include "SistemDecizional.h"

inline long double decideDirectiaDrumSimplu(uint8_t linie) //Se va modifica pentru obstacole si curbe

{

//In functie de linie se calculeaza o valoare pentru unghi intre -1 si 1

long double temp = 128;

temp-=2*SERVOMOTOR_THRESHOLD;

temp=(linie - SERVOMOTOR_THRESHOLD)/temp;

temp*=2;

temp-=1;

return temp;

}

inline float decideVitezaDrumSimplu(uint8_t linie)

{

//In functie de pozitia liniei, platforma se va deplasa mai repede sau mai incet

if(linie>=63 + LINE_MAX_ERROR_FOR_SPEED || linie<=64 - LINE_MAX_ERROR_FOR_SPEED)

{

return MOTOARE_VITEZA_CURBA_MS;

}

else

{

return MOTOARE_VITEZA_MAX_MS;

}

}

## 8.7. Anexa 7

Această anexă conține codul fișierului Uart.c.

#include "Uart.h"

uint32_t osr = 15;

uint16_t sbr;

uint8_t temp;

extern uint8_t cameraPixels[128];

void uartInit(uint32_t baud){

//Activam ceasul pentru modulul UART0

SIM->SCGC4 |= SIM_SCGC4_UART0_MASK;

//Dezactivam RX, TX pentru configurare

UART0->C2 &= ~UART0_C2_TE_MASK & ~UART0_C2_RE_MASK;

//Setam ceasul

SIM->SOPT2 |= SIM_SOPT2_UART0SRC(01);

SIM->SOPT2 |= SIM_SOPT2_PLLFLLSEL_MASK;

//Setam pinii folositi

PORTA->PCR[1] = PORT_PCR_ISF_MASK | PORT_PCR_MUX(2);

PORTA->PCR[2] = PORT_PCR_ISF_MASK | PORT_PCR_MUX(2);

sbr = (uint16_t)((BUS_CLOCK)/(baud * (osr+1)));

temp = UART0->BDH & ~(UART0_BDH_SBR(0x1F));

UART0->BDH = temp | UART_BDH_SBR(((sbr & 0x1F00) >> 8));

UART0->BDL = (uint8_t)(sbr & UART_BDL_SBR_MASK);

UART0->C4 |= UART0_C4_OSR(osr);

//Mentinem majoritatea pe default

UART0->C1 = 0;

UART0->C3 = 0;

UART0->MA1 = 0;

UART0->MA2 = 0;

UART0->S1 |= 0x00;

UART0->S2 = 0x00;

//Activam UART0

UART0->C2 |= UART0_C2_TE_MASK | UART0_C2_RE_MASK;

}

void trimiteDate(uint8_t data)

{

while(!(UART0->S1 & UART_S1_TDRE_MASK));

UART0->D = data;

}

uint8_t primesteDate(void)

{

while(!(UART0->S1 & UART_S1_RDRF_MASK));

return UART0->D;

}

## 8.8. Anexa 8

Această anexă conține codul fișierului PID.c.

#include "PID.h"

#include "Uart.h"

static float kp = 0;

static float kd = 0;

static float ki = 0;

static float eroare = 0;

static float integral = 0;

void initializarePID(float TS, float KP, float KI, float KD)

{

//Se initializeaza pidul

kp = KP;

ki = KI*TS;

kd = KD/TS;

integral = 0;

eroare = 0;

}

float getNextPid(float referinta, float output)

{

//Se calculeaza valoarea noua a semnalului

float up, ud, e;

e = referinta - output;

up = e * kp;

integral += ki * (e + eroare) / 2;

ud = kd * (e - eroare);

eroare = e;

return up + ud + integral;

}

## 8.9. Anexa 9

Această anexă conține codul fișierului SenzoriDistanta.c.

#include "SenzoriDistanta.h"

#include "Uart.h"

float volatile distantaS = 100;

float volatile distantaD = 100;

float volatile distantaC = 100;

void PORTA_IRQHandler(void)

{

NVIC_ClearPendingIRQ(PORTA_IRQn);

uint32_t value = TPM0->CNT;

if(PORTA_ISFR & 1<<PortSenzorDistantaCPin)

{

//Se calculeaza distanta fata de senzor

distantaC = FACTOR_MUL_DISTANTA * value;

PORTA_ISFR |= 1<<PortSenzorDistantaCPin;

distantaC -= DISTANTA_EROARE;

}

#if (SENZOR_DISTANTA_DEBUG_C == 1)

trimiteDate(distantaC);

#endif

}

void PORTD_IRQHandler(void)

{

NVIC_ClearPendingIRQ(PORTD_IRQn);

uint32_t value = TPM0->CNT;

if(PORTD_ISFR & 1<<PortSenzorDistantaSPin)

{

//Se calculeaza distanta fata de senzor

distantaS = FACTOR_MUL_DISTANTA * value;

PORTD_ISFR |= 1<<PortSenzorDistantaSPin;

distantaS -= DISTANTA_EROARE;

#if (SENZOR_DISTANTA_DEBUG_S == 1)

trimiteDate(distantaS);

#endif

}

if(PORTD_ISFR & 1<<PortSenzorDistantaDPin)

{

//Se calculeaza distanta fata de senzor

distantaD = FACTOR_MUL_DISTANTA * value;

PORTD_ISFR |= 1<<PortSenzorDistantaDPin;

distantaD -= DISTANTA_EROARE;

#if (SENZOR_DISTANTA_DEBUG_D == 1)

trimiteDate(distantaD);

#endif

}

}

void initializareSenzoriDistanta(void)

{

//Configurare pin trigger

PortSenzorDistantaTrig |= PORT_PCR_MUX(PortSenzorDistantaTrigMux);

PortSenzorDistantaTrig |= PORT_PCR_PE(1) & (~PORT_PCR_PS(1));

//Configuram pinii pentru echo

PortSenzorDistantaEchoS |= PORT_PCR_MUX(PortSenzorDistantaEchoSM);

PortSenzorDistantaEchoD |= PORT_PCR_MUX(PortSenzorDistantaEchoDM);

PortSenzorDistantaEchoC |= PORT_PCR_MUX(PortSenzorDistantaEchoCM);

PortSenzorDistantaEchoS |= PORT_PCR_PE(1) & (~PORT_PCR_PS(1));

PortSenzorDistantaEchoD |= PORT_PCR_PE(1) & (~PORT_PCR_PS(1));

PortSenzorDistantaEchoC |= PORT_PCR_PE(1) & (~PORT_PCR_PS(1));

PortSenzorDistantaEchoS |= PORT_PCR_IRQC(0xA);

PortSenzorDistantaEchoD |= PORT_PCR_IRQC(0xA);

PortSenzorDistantaEchoC |= PORT_PCR_IRQC(0xA);

//Dezactivare modul pe timpul configurarii

TPM0->SC &= ~(TPM_SC_CMOD(1));

//Setare mod Edge-Aligned PWM

TPM0->CONTROLS[4].CnSC = TPM_CnSC_MSB_MASK | TPM_CnSC_ELSB_MASK;

//Setare factor de umplere

TPM0->CONTROLS[4].CnV = SENZOR_DISTANTA_PWM;

//Activare modul TPM0

TPM0->SC |= TPM_SC_CMOD(1);

NVIC_SetPriority(PORTA_IRQn, 128);

NVIC_ClearPendingIRQ(PORTA_IRQn);

NVIC_EnableIRQ(PORTA_IRQn);

NVIC_SetPriority(PORTD_IRQn, 128);

NVIC_ClearPendingIRQ(PORTD_IRQn);

NVIC_EnableIRQ(PORTD_IRQn);

}

NECLASIFICAT 2 din 81
