VladTeapa/Platforma-Autonoma-KL25Z/Prezentare Hariga.pptx

ROMÂNIA
ACADEMIA TEHNICĂ MILITARĂ “FERDINAND I”
FACULTATEA DE SISTEME INFORMATICE ȘI SECURITATE CIBERNETICĂ

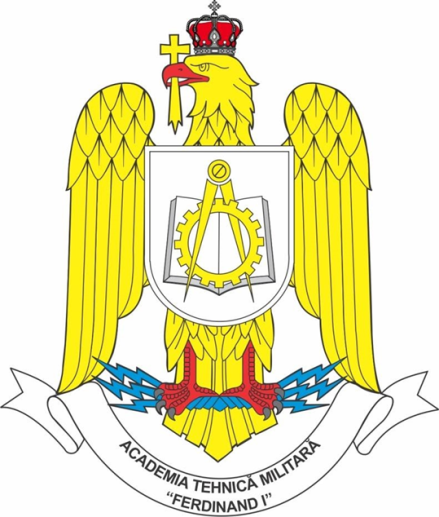
[picture p37: figure]

PLATFORMĂ AUTONOMĂ MOBILĂ CARE SE DEPLASEAZĂ URMÂND UN TRASEU MARCAT, IDENTIFICAT PRIN ANALIZĂ DE IMAGINE, CU OPTIMIZAREA TIMPULUI DE PARCURGERE A UNEI PORȚIUNI DELIMITATE DE TRASEU

Coordonator științific
Conf. univ. dr. ing Laurențiu MĂRGĂRIT
Absolvent
Student plt. maj. George-Codrin HARIGA

BUCUREȘTI
SESIUNEA IULIE 2021

## Cuprins

- Alegerea problemei;
- Obiectivele proiectului;
- Dezvoltarea proiectului;
- Probleme întâmpinate;
- Direcții de dezvoltare.

## Alegerea Problemei (I)

- Acest proiect a fost inițial dezvoltat pentru a participa la competiția NXP Cup, care are mai multe probe:
  - Parcurgerea unui traseu delimitat;
  - Ocolirea obstacolelor;
  - Recunoașterea semnelor de circulație.
- Inițial proiectul urma să fie combinat cu altă lucrare de licență care detectează semnele de circulație pentru a realiza toate cele trei scenarii.

## Alegerea Problemei (II)

- La nivel global au început să apară din ce în ce mai multe tehnologii de automatizare a conducerii a unui autoturism;
- Aceste tehnologii pot fi folosite pentru a mări comfortul șoferului pe timpul condusului;
- Câteva exemple de astfel de tehnologii sunt:
  - Cruise Control;
  - Line Assist;
  - Tesla Smart Summon.

## Alegerea Problemei (III)

- În același timp, aceste tehnologii pot fi și folosite și pentru a mări siguranța șoferului și a celor din jur;
- Spre exemplu, un sistem de detecție a autovehiculelor aflate în fața autoturismului.
- Acest sistem poate acționa frâna în cazul în care distanța de siguranță este foarte mică și se poate produce o coliziune.

## Obiectivele proiectului

- Proiectul își propune realizarea unei platforme autonome cu următoarele funcționalități:
  - Menținerea un traseu marcat;
  - Ocolirea obstacolelor care apar pe timpul deplasării.

## Dezvoltarea proiectului (I)

- Platforma de dezvoltare folosită este produsă de NXP, model FRDM-KL25Z;
- Amplificarea semnalelor s-a realizat cu ajutorul unui circuit logic M74HCT244B1;
- Inversarea polarității tensiunii de alimentare a motoarelor s-a realizat cu ajutorul unui multiplexor 74157N;
- Celelalte componente folosite pot fi găsite în documentația proiectului;
- Software-ul dezvoltat este de tip ,,bare-metal” și a fost realizat cu ajutorul IDE-ului Keil µVision.

## Dezvoltarea proiectului (II)

Sistemul verifică starea în care se află:
Dacă este în starea fără obstacole, stabiliește viteza, unghiul servomotorului și verifică dacă au apărut obstacole;
Dacă este în starea cu obstacole, sistemul verifică direcția pe care se află obstacolul, setează viteza și direcția corespunzător, verificând dacă mai este detectat vreun obstacol.
Prin intermediul întreruperilor sunt realizate următoarele:
Calcularea semnalului pentru motoare, după măsurarea turației (PID);
Preluarea datelor de la cameră;
Măsurarea distanței cu ajutorul senzorilor de distanță.

## PROBLEME întâmpinate

- Una din punțile H se încălzea foarte rapid, iar siguranțele termice opreau alimentarea întregului circuit;
  - Pentru a rezolva problema s-au legat motoarele în serie.
- Servomotorul nu menține perfect roțile drepte când este dată comanda pentru unghiul 0;
  - S-a introdus un factor de corecție la apelul funcției.
- Pinul PTA4 nu s-a putut configura întrucât este preconfigurat.
  - S-a ales alt pin.

## Direcții de dezvoltare

- Pe viitor, această platformă poate fi îmbunătățită prin adăugarea de funcții precum:
  - Detectarea semnelor de circulație;
  - Parcarea automată.

## Slide 11

ROMÂNIA
ACADEMIA TEHNICĂ MILITARĂ “FERDINAND I”
FACULTATEA DE SISTEME INFORMATICE ȘI SECURITATE CIBERNETICĂ

Vă mulțumesc pentru atenție

PLATFORMĂ AUTONOMĂ MOBILĂ CARE SE DEPLASEAZĂ URMÂND UN TRASEU MARCAT, IDENTIFICAT PRIN ANALIZĂ DE IMAGINE, CU OPTIMIZAREA TIMPULUI DE PARCURGERE A UNEI PORȚIUNI DELIMITATE DE TRASEU

Coordonator științific
Conf. univ. dr. ing Laurențiu MĂRGĂRIT
Absolvent
Student plt. maj. George-Codrin HARIGA

BUCUREȘTI
SESIUNEA IULIE 2021
