VladTeapa/Platforma-Autonoma-KL25Z/SistemDecizional.h

#include "MKL25Z4.h"
#include "Defines.h"
#include "Motoare.h"
long double decideDirectiaDrumSimplu(uint8_t linie); //Functie care returneaza o valoare a unghiului in functie de linie
float decideVitezaDrumSimplu(uint8_t linie); //Functie care returneaza o valoarea a vitezei in functie de linie
