VladTeapa/Platforma-Autonoma-KL25Z/SenzoriDistanta.h

#include "Defines.h"
void initializareSenzoriDistanta(void); //Initalizare pini si tmp pentru senzori distanta
void PORTA_IRQHandler(void); //Intrerupere pentru port A
void PORTD_IRQHandler(void); //Intrerupere pentru port D
