VladTeapa/Platforma-Autonoma-KL25Z/(commit log)

2021-04-03 Modificat algoritm de cautare linie part 1
2021-04-03 Modificare algoritm camera part 2
2021-04-05 Algoritm camera plus pid
2021-04-20 Parcurgere drum terminata
    Issue: #2
    Mai trebuie putin reglati parametrii PID-ului
    [Camera.c, Camera.h, Defines.h, Main.c, Motoare.c, Motoare.h, PID.c, PID.h]
2021-05-19 Sistem rudimentar de ocolire Trebuie testat!
2021-06-03 Schimbare PID
2021-06-03 PID modificare motoare serie
2021-06-03 Pid aproape perfect
2021-06-07 PID stabil dar cu un offset
2021-06-07 Retusari finale + scris la documentatie
2021-06-26 1.0
    Adaugat script matlab, retusat document, modificat parametrii PID
